beetlebugorg/bittlex/bittle_pi_addon/doc/02_addon.png

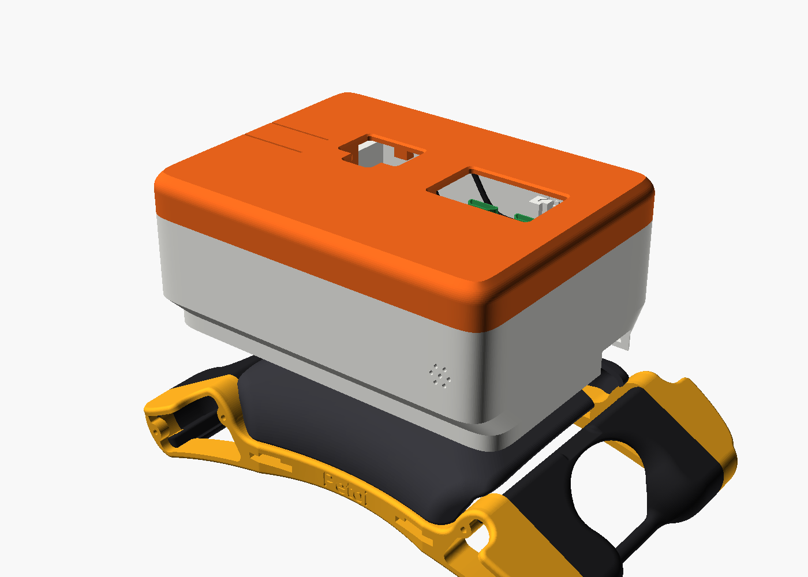
bittle_pi_addon/doc/02_addon.png
