beetlebugorg/bittlex/bittle_pi_addon/doc/03_rear.png

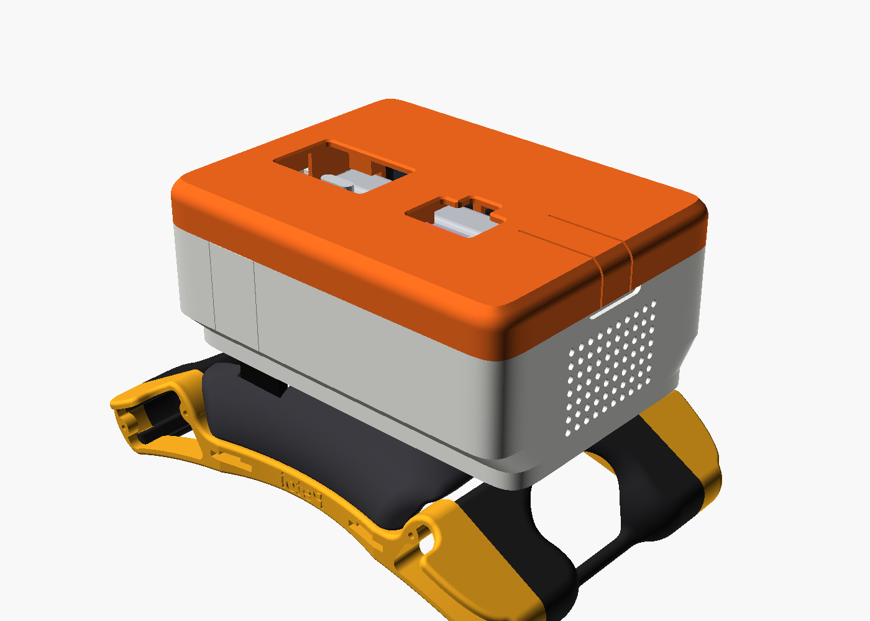
bittle_pi_addon/doc/03_rear.png
