beetlebugorg/bittlex/bittle_pi_addon/doc/04_top.png

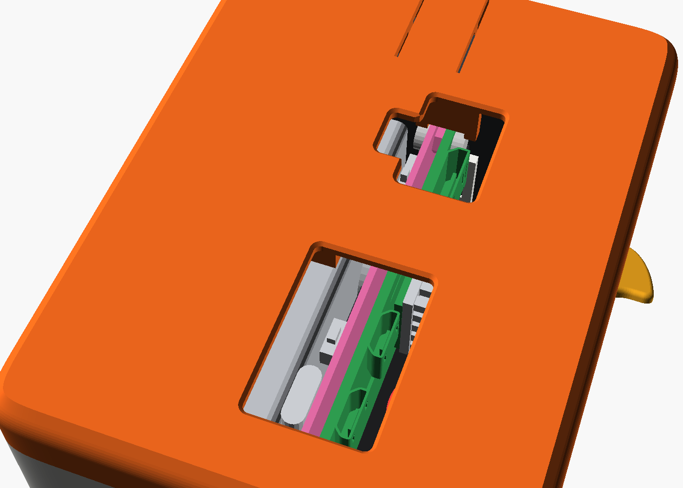
bittle_pi_addon/doc/04_top.png
