beetlebugorg/bittlex/bittle_pi_addon/doc/05_front_notch.png

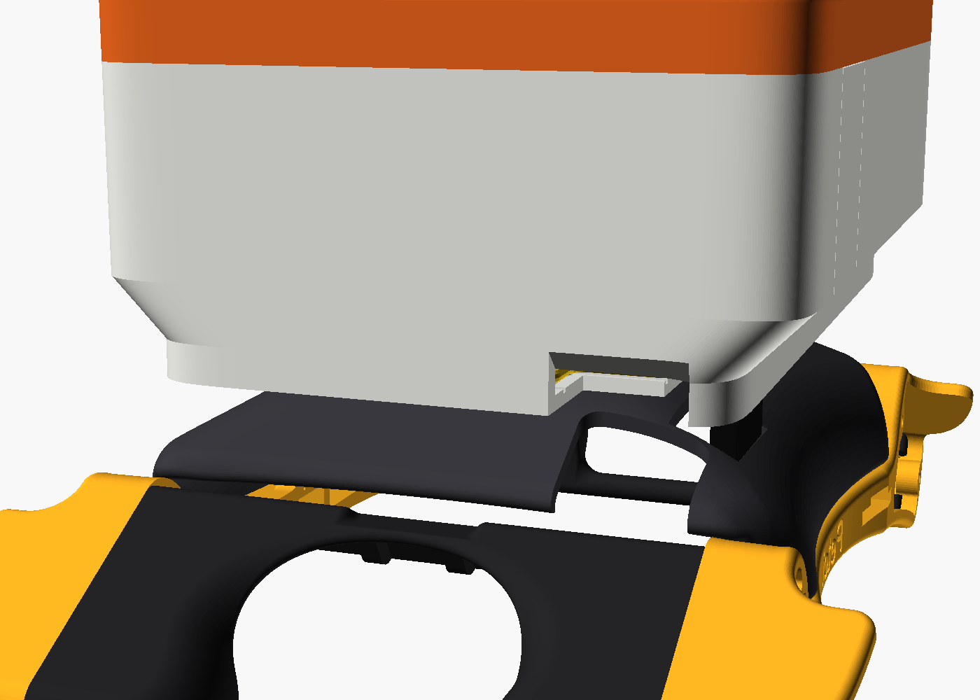
bittle_pi_addon/doc/05_front_notch.png
