beetlebugorg/bittlex/bittle_pi_addon/doc/07_open_left.png

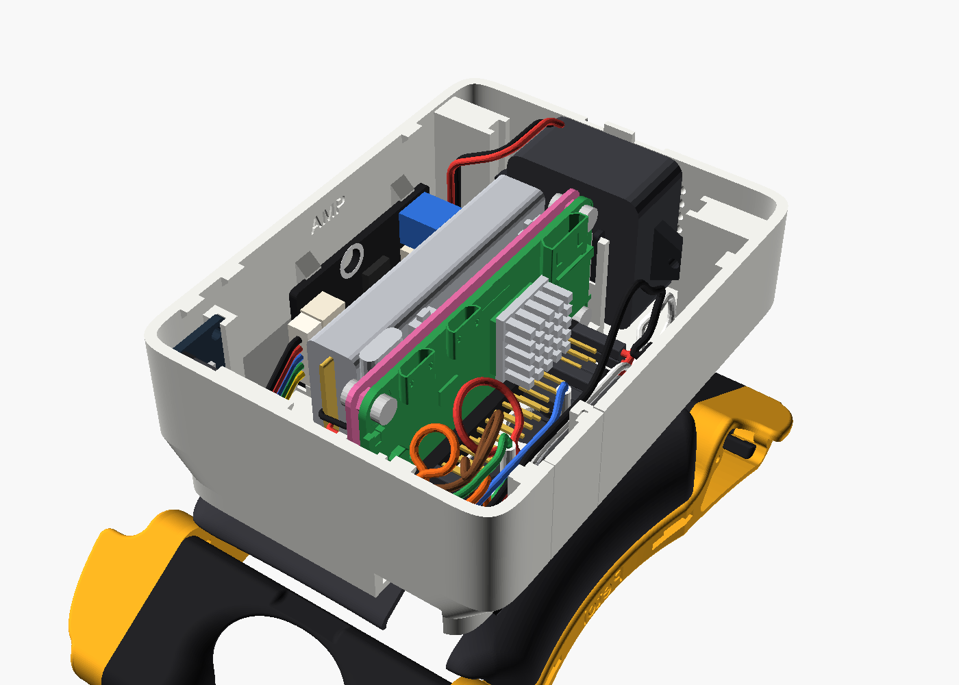
bittle_pi_addon/doc/07_open_left.png
