beetlebugorg/bittlex/bittle_pi_addon/doc/12_wires_left.png

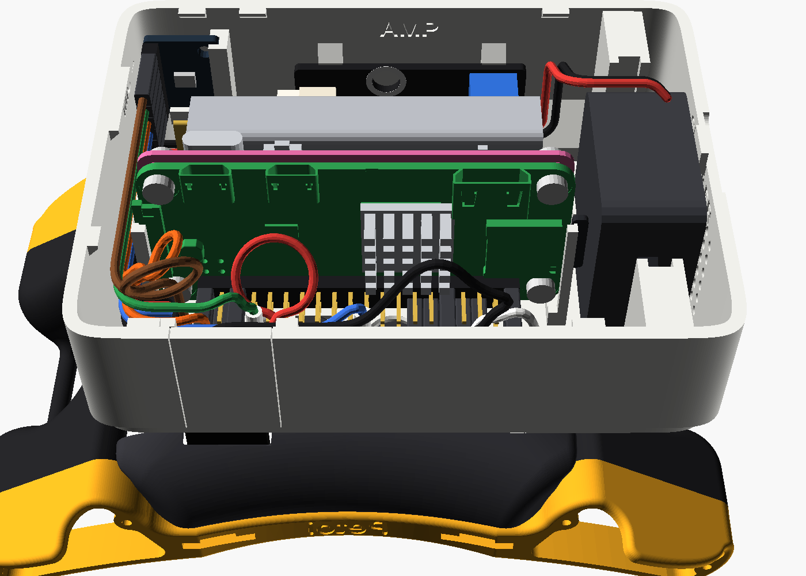
bittle_pi_addon/doc/12_wires_left.png
