beetlebugorg/bittlex/bittle_pi_addon/doc/cover.png

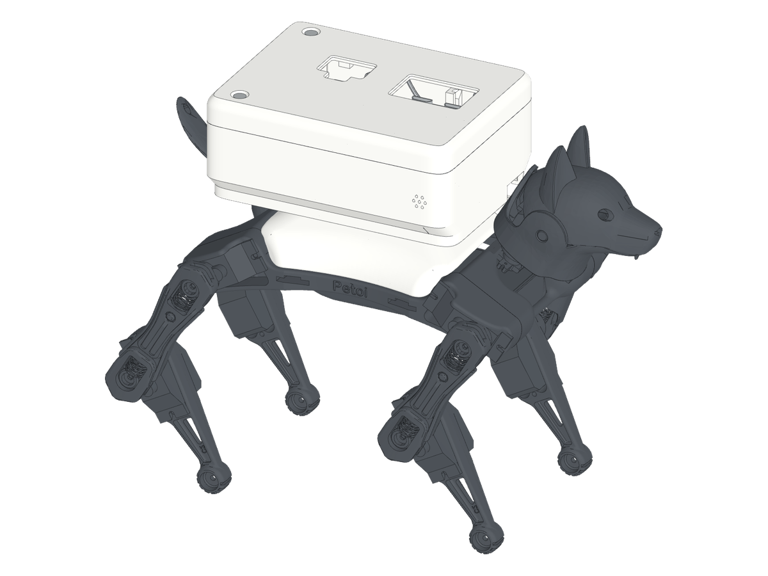
bittle_pi_addon/doc/cover.png
