beetlebugorg/bittlex/bittle_pi_addon/doc/iso/cover-dark.png

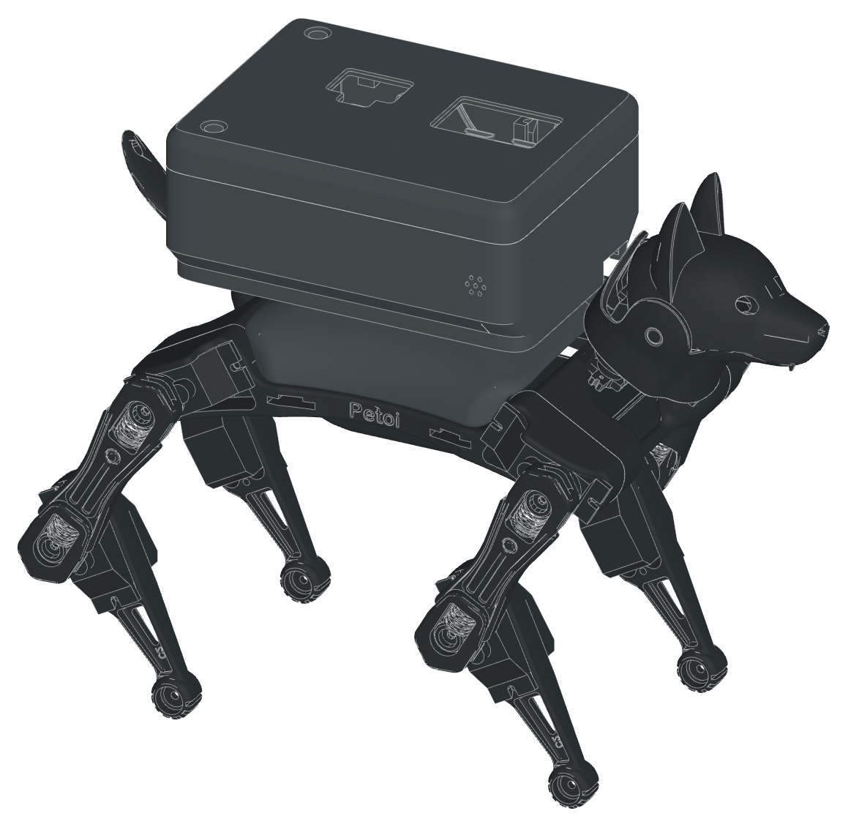
bittle_pi_addon/doc/iso/cover-dark.png
