beetlebugorg/bittlex/bittle_pi_addon/doc/iso/cover-light.png

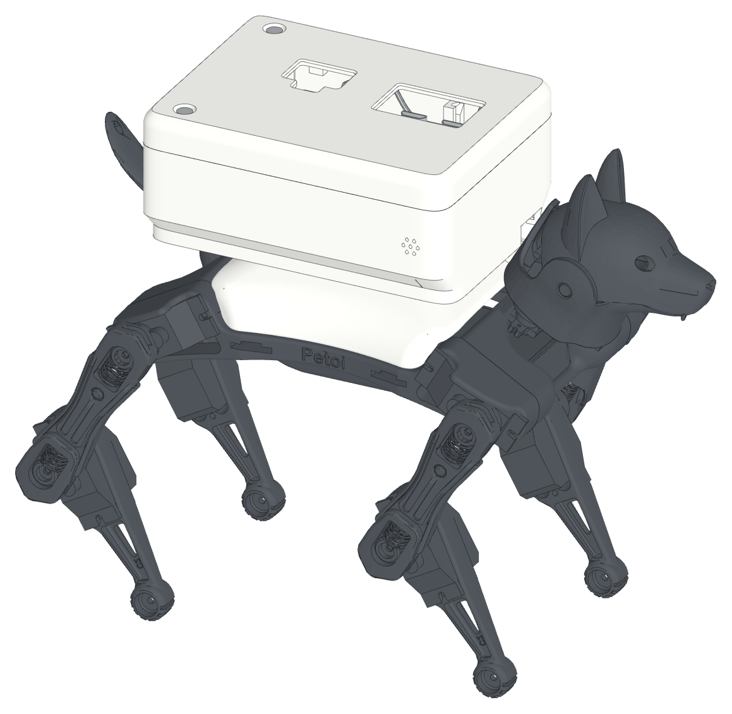
bittle_pi_addon/doc/iso/cover-light.png
