beetlebugorg/bittlex/bittle_pi_addon/doc/iso/exploded-dark.png

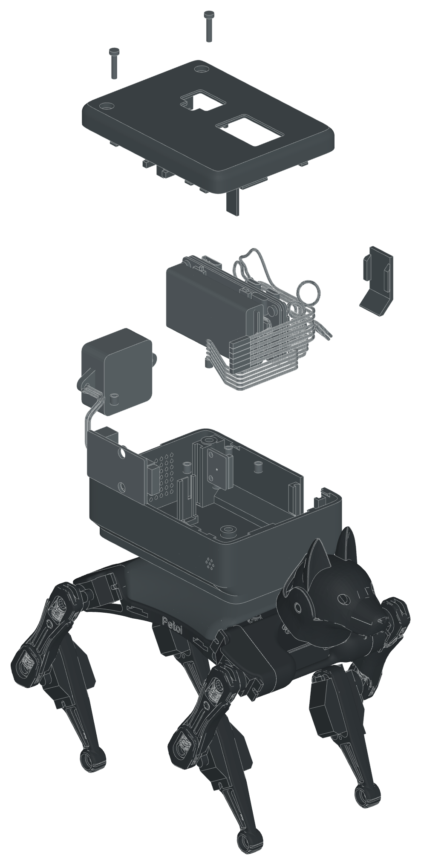
bittle_pi_addon/doc/iso/exploded-dark.png
