beetlebugorg/bittlex/bittle_pi_addon/doc/iso/hero-color-dark.png

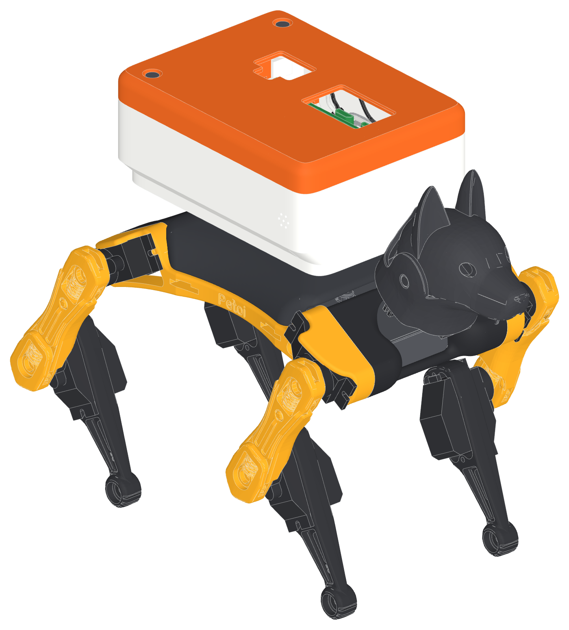
bittle_pi_addon/doc/iso/hero-color-dark.png
