beetlebugorg/bittlex/bittle_pi_addon/doc/iso/hero-dark.png

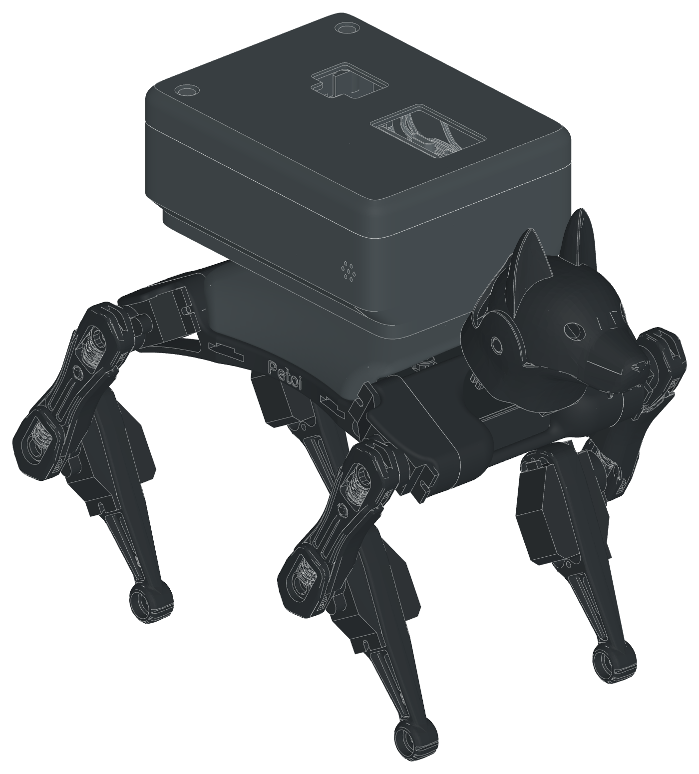
bittle_pi_addon/doc/iso/hero-dark.png
