beetlebugorg/bittlex/bittle_pi_addon/doc/iso/wires-dark.png

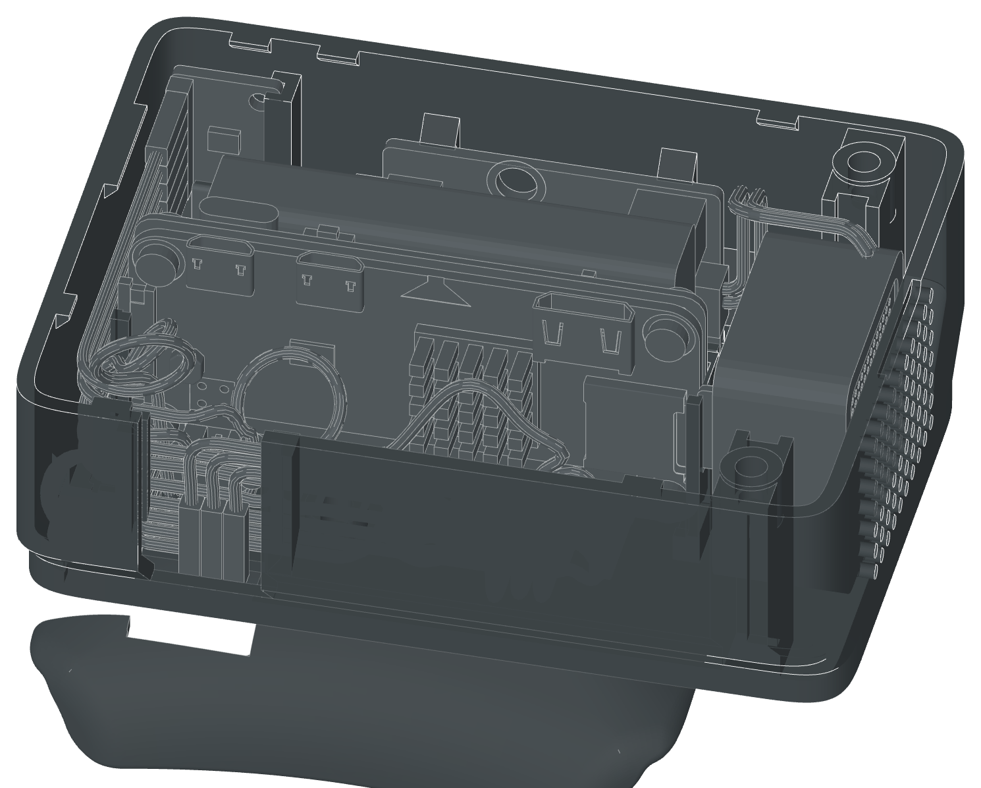
bittle_pi_addon/doc/iso/wires-dark.png
