beetlebugorg/bittlex/bittle_platform/doc/r2_starter.png

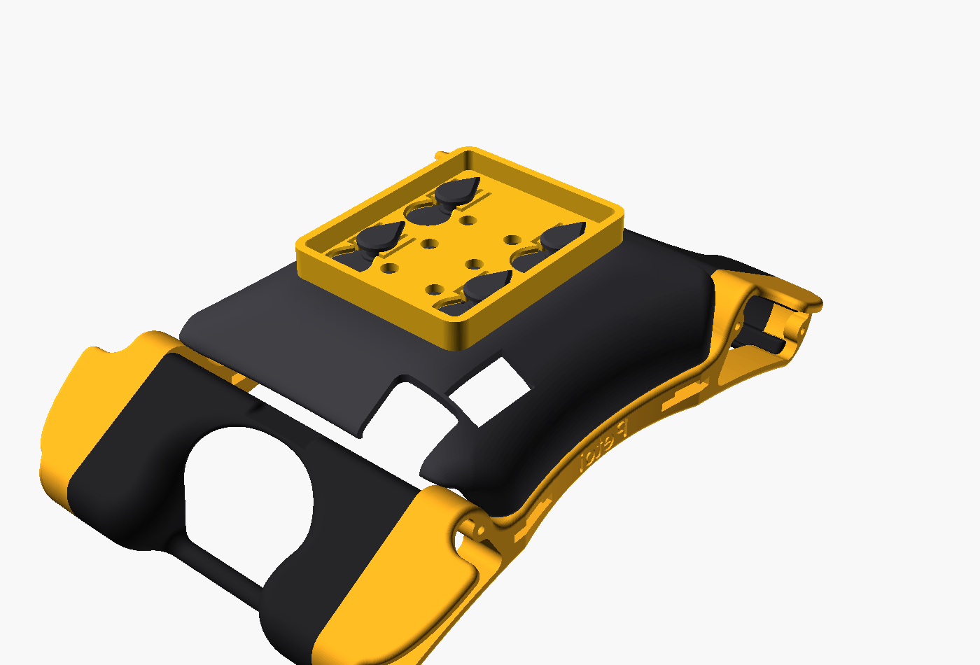
bittle_platform/doc/r2_starter.png
