beetlebugorg/bittlex/bittle_pi_addon/cad/pod_door.step

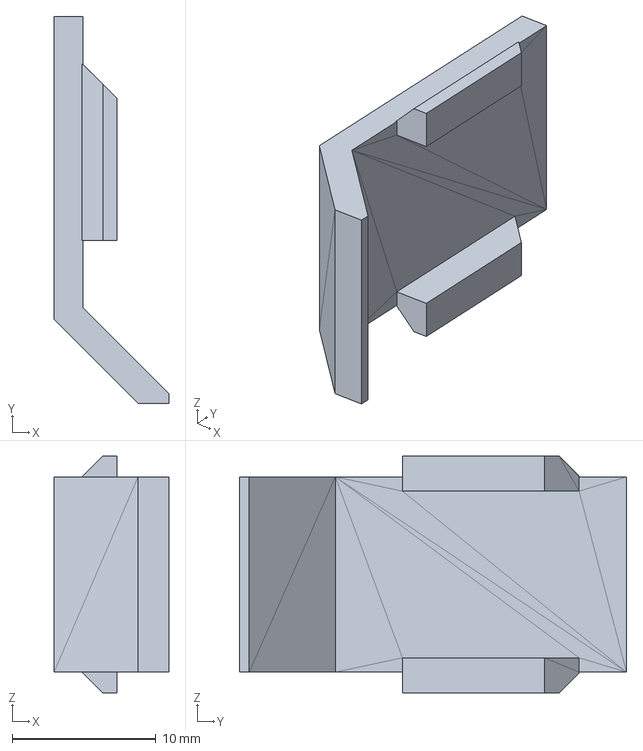
[picture p52: CAD file, 2026-11-01]
bittle_pi_addon/cad/pod_door.step
8.00 x 26.9 x 16.5 mm
