beetlebugorg/bittlex/bittle_pi_addon/stl/assembly/fdm/mount_inserts.stl

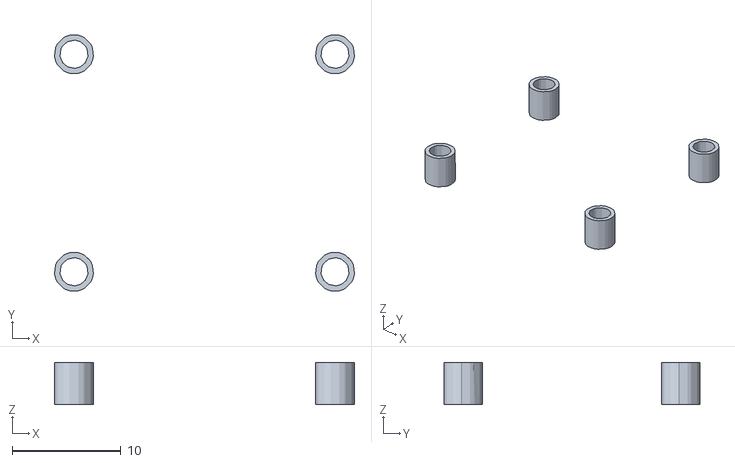
[picture p53: CAD file, 2026-11-03]
bittle_pi_addon/stl/assembly/fdm/mount_inserts.stl
27.6 x 23.5 x 3.90
