beetlebugorg/bittlex/bittle_pi_addon/stl/models/parts/wires_uart__gnd.stl

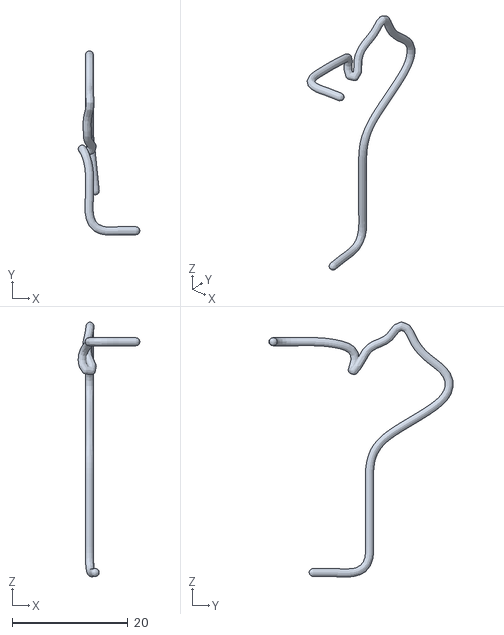
[picture p54: CAD file, 2026-10-31]
bittle_pi_addon/stl/models/parts/wires_uart__gnd.stl
10.7 x 31.8 x 44.0
