beetlebugorg/bittlex/bittle_pi_addon/stl/models/wires_uart.stl

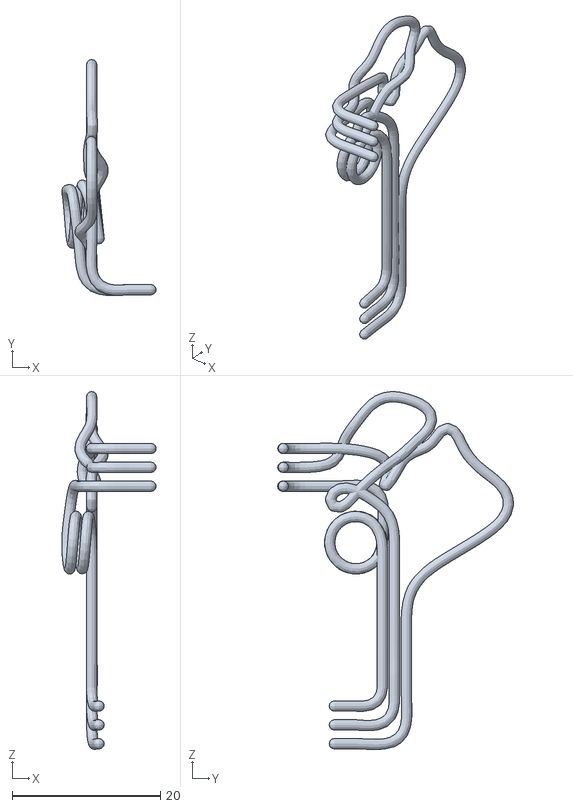
[picture p55: CAD file, 2026-10-31]
bittle_pi_addon/stl/models/wires_uart.stl
12.7 x 31.8 x 48.3
