beetlebugorg/bittlex/bittle_pi_addon/stl/plates/fdm_taz_plate.stl

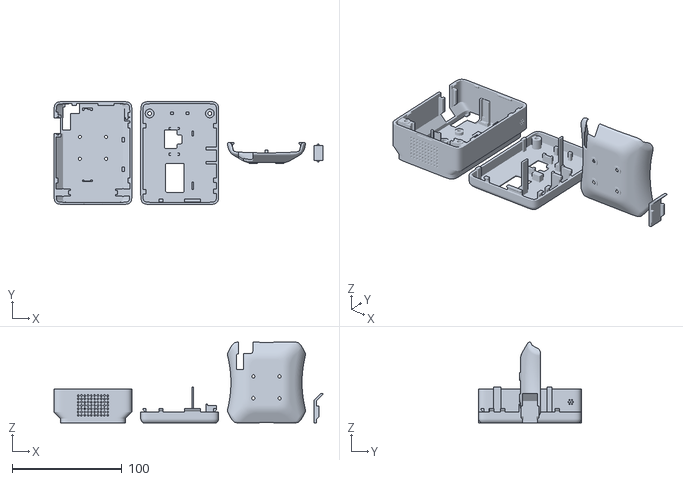
[picture p56: CAD file, 2026-11-01]
bittle_pi_addon/stl/plates/fdm_taz_plate.stl
245.6 x 94.0 x 73.9
