beetlebugorg/bittlex/bittle_pi_addon/stl/print/pod_door_fine.stl

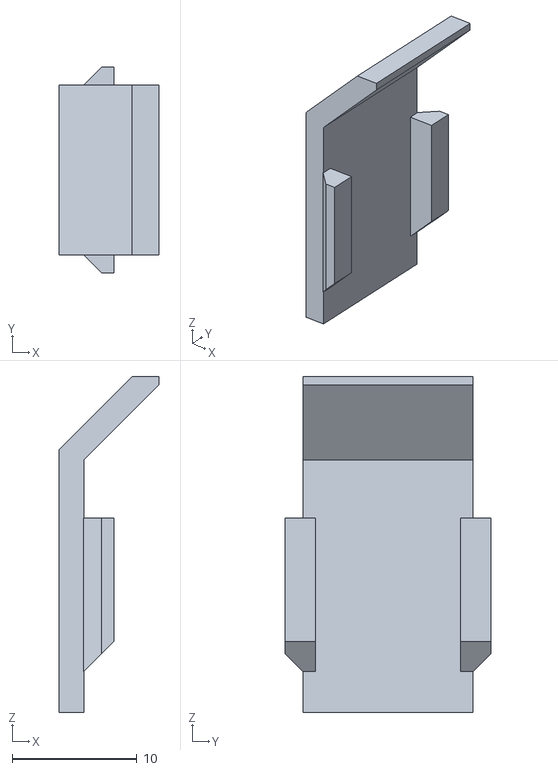
[picture p57: CAD file, 2026-11-01]
bittle_pi_addon/stl/print/pod_door_fine.stl
8.00 x 16.5 x 27.0
