beetlebugorg/bittlex/bittle_platform/cad/detent_bumps.step

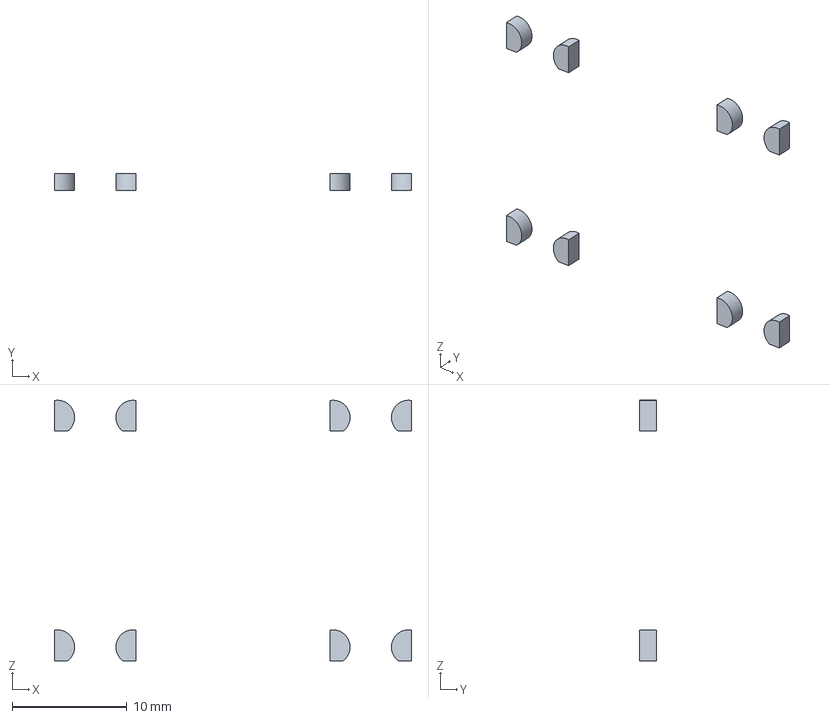
[picture p58: CAD file, 2026-10-31]
bittle_platform/cad/detent_bumps.step
31.1 x 1.50 x 22.7 mm
