beetlebugorg/bittlex/bittle_platform/stl/fit_fine/keyhole_fit_5_gap0.10_click0.35.stl

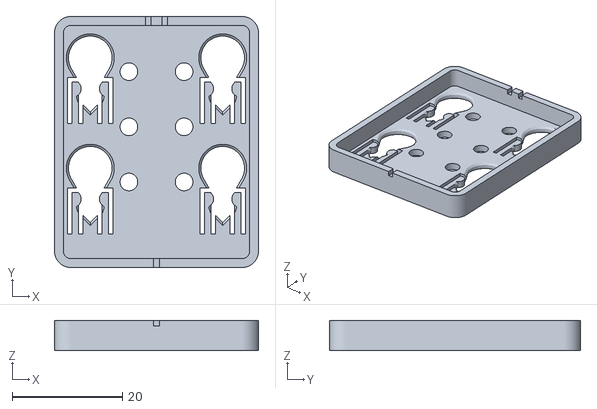
[picture p59: CAD file, 2026-10-31]
bittle_platform/stl/fit_fine/keyhole_fit_5_gap0.10_click0.35.stl
37.0 x 45.5 x 5.50
