beetlebugorg/bittlex/bittle_platform/stl/print/cover_pegs.stl

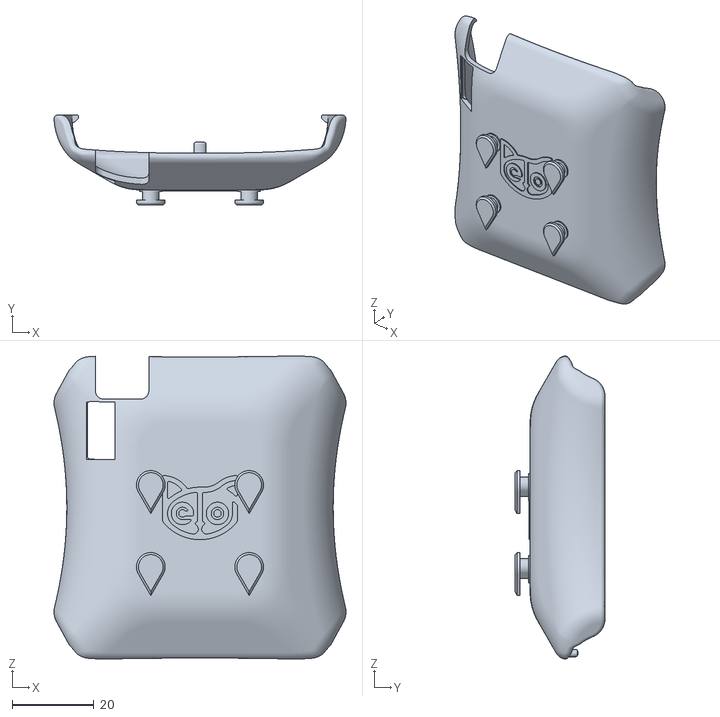
[picture p60: CAD file, 2026-10-31]
bittle_platform/stl/print/cover_pegs.stl
71.2 x 22.0 x 73.9
