beetlebugorg/bittlex/bittle_pi_addon/cad/pod_panel.step

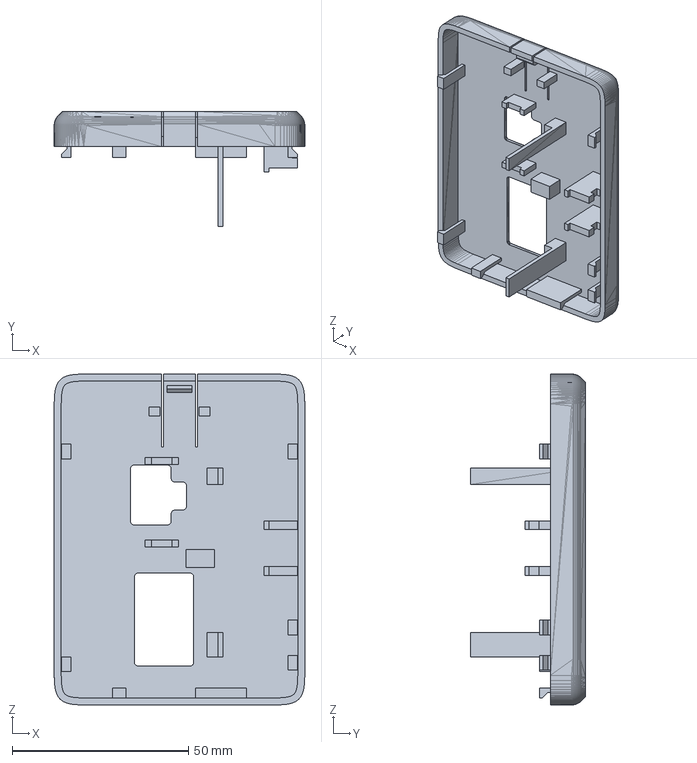
[picture p61: CAD file, 2026-10-31]
bittle_pi_addon/cad/pod_panel.step
71.2 x 32.7 x 94.0 mm
