beetlebugorg/bittlex/bittle_pi_addon/stl/assembly/fdm/panel_inserts.stl

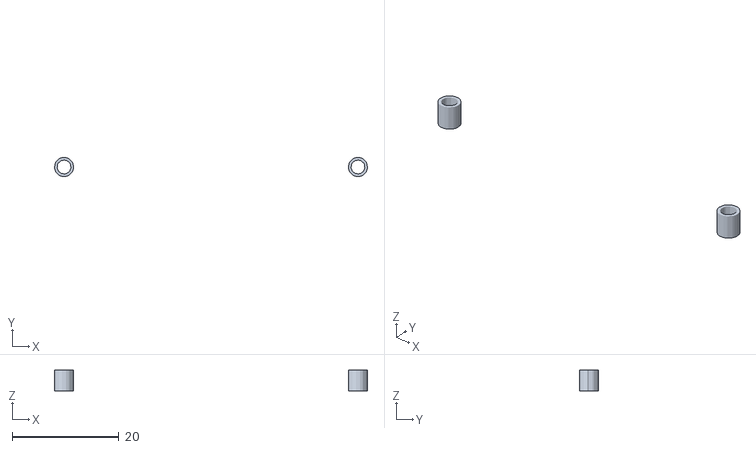
[picture p62: CAD file, 2026-11-03]
bittle_pi_addon/stl/assembly/fdm/panel_inserts.stl
58.6 x 3.51 x 3.90
