beetlebugorg/bittlex/bittle_pi_addon/stl/assembly/resin/pod_panel.stl

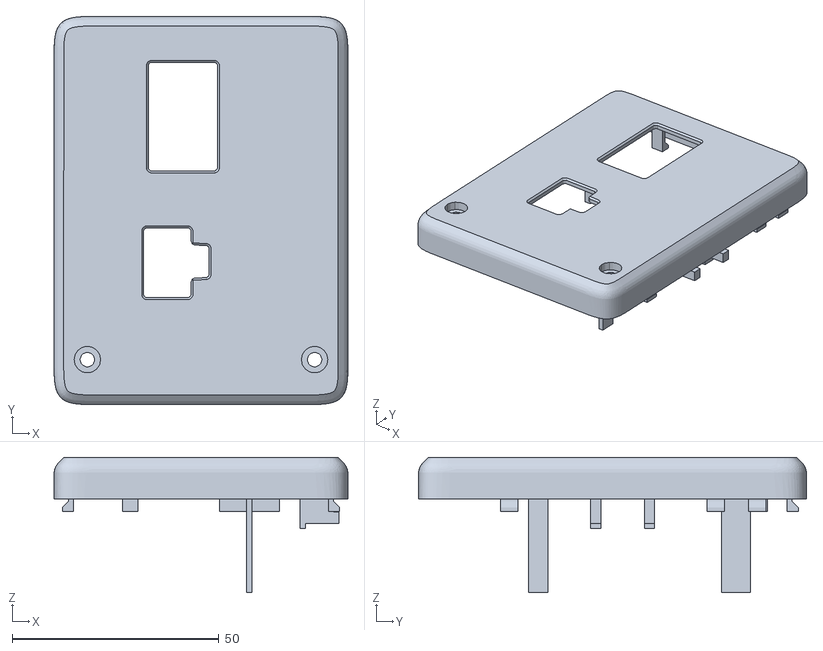
[picture p63: CAD file, 2026-11-02]
bittle_pi_addon/stl/assembly/resin/pod_panel.stl
71.1 x 93.9 x 32.7
