beetlebugorg/bittlex/bittle_pi_addon/stl/models/parts/wires_uart__rx2.stl

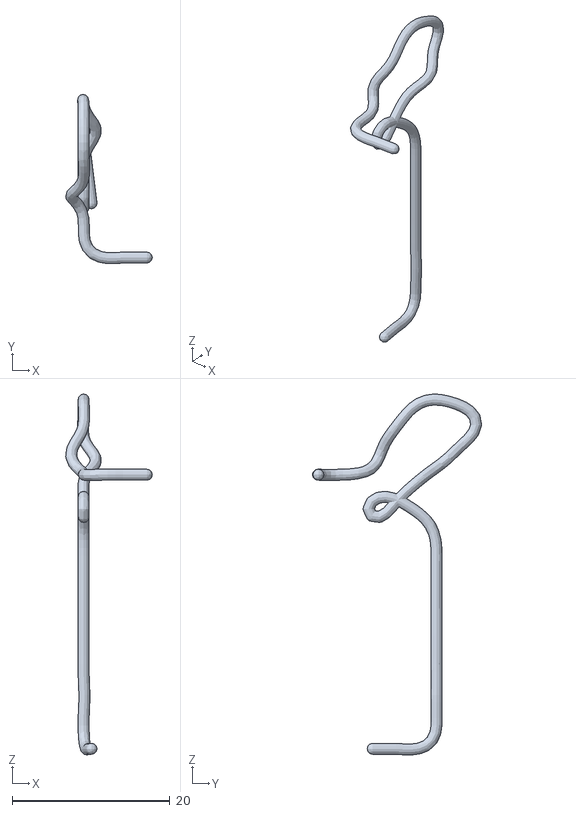
[picture p64: CAD file, 2026-10-31]
bittle_pi_addon/stl/models/parts/wires_uart__rx2.stl
11.0 x 21.4 x 45.7
