beetlebugorg/bittlex/bittle_pi_addon/stl/models/wires_mic.stl

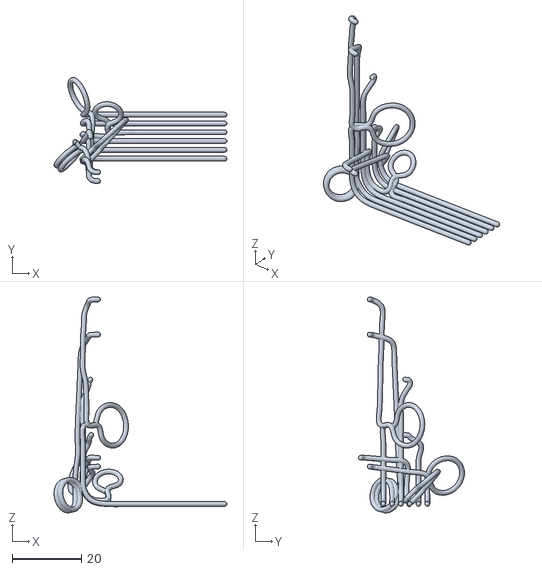
[picture p65: CAD file, 2026-10-31]
bittle_pi_addon/stl/models/wires_mic.stl
49.9 x 30.6 x 62.3
