beetlebugorg/bittlex/bittle_pi_addon/stl/plates/resin_phenom.3mf

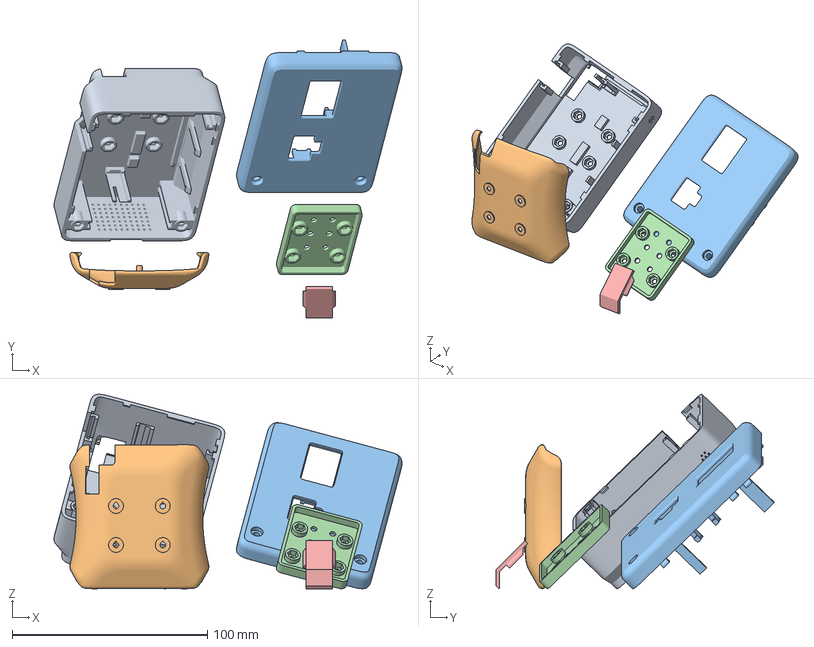
[picture p66: CAD file, 2026-11-01]
bittle_pi_addon/stl/plates/resin_phenom.3mf
178.4 x 142.7 x 99.8 mm
pod_body
cover_screw
pod_panel
starter_plate_screw
pod_door
