beetlebugorg/bittlex/bittle_platform/cad/pegs.step

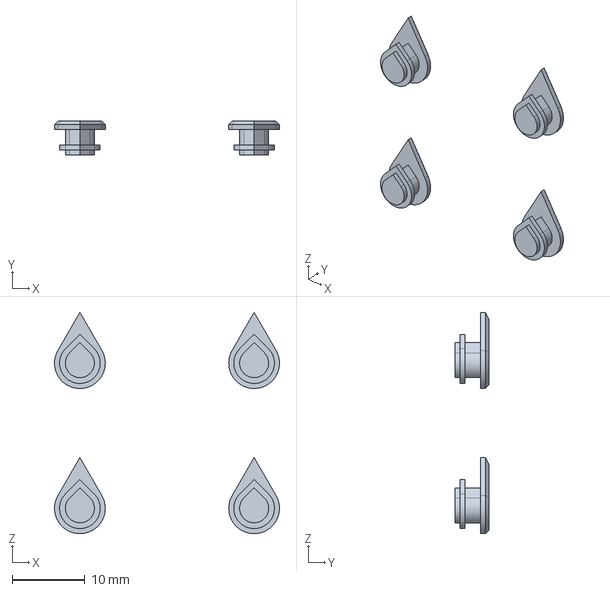
[picture p67: CAD file, 2026-10-31]
bittle_platform/cad/pegs.step
31.0 x 4.70 x 30.5 mm
