beetlebugorg/bittlex/bittle_platform/stl/print/cover_pegs_foot.stl

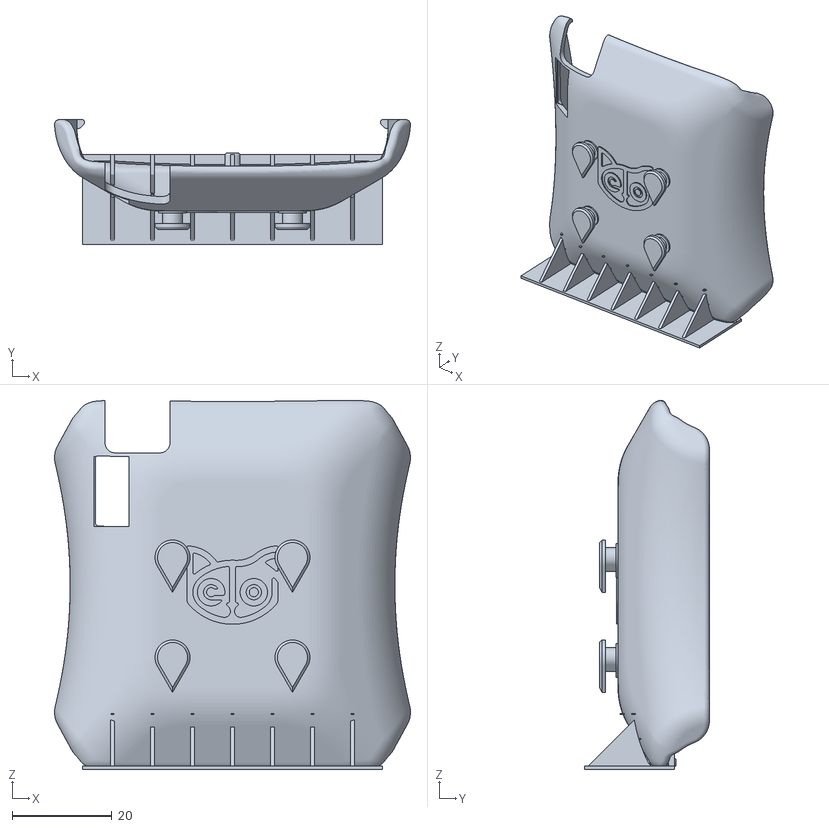
[picture p68: CAD file, 2026-10-31]
bittle_platform/stl/print/cover_pegs_foot.stl
71.2 x 25.0 x 73.9
