beetlebugorg/bittlex/bittle_pi_addon/cad/pod_body.step

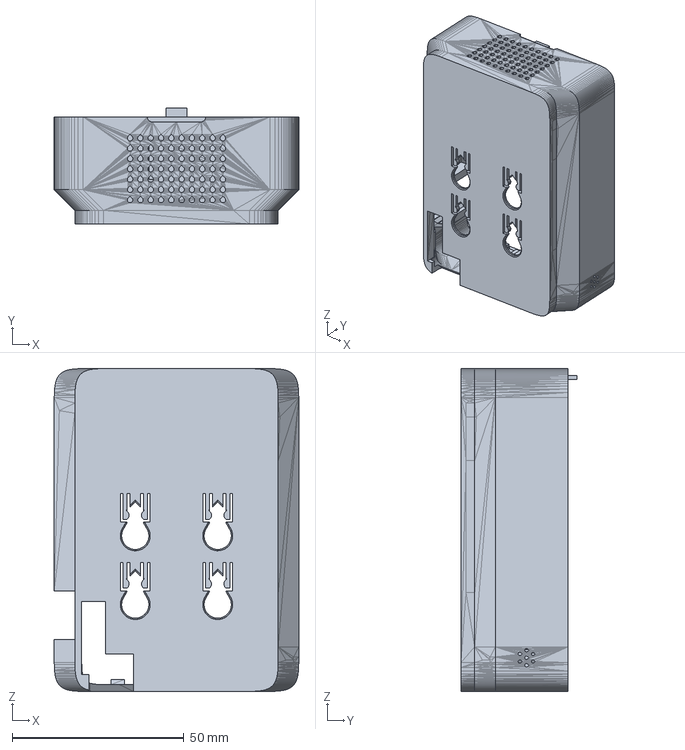
[picture p69: CAD file, 2026-10-31]
bittle_pi_addon/cad/pod_body.step
71.2 x 33.8 x 94.0 mm
