beetlebugorg/bittlex/bittle_pi_addon/stl/assembly/fdm/wires_amp_2e9b4f.stl

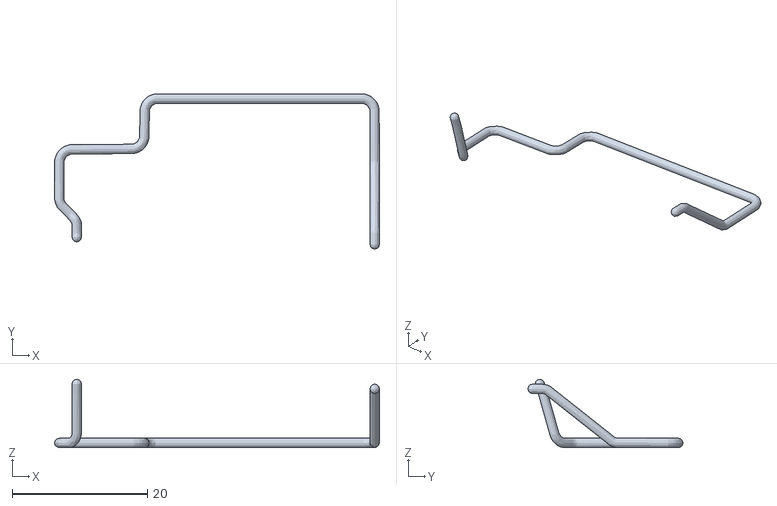
[picture p70: CAD file, 2026-11-03]
bittle_pi_addon/stl/assembly/fdm/wires_amp_2e9b4f.stl
48.0 x 22.9 x 10.1
