beetlebugorg/bittlex/bittle_pi_addon/stl/models/parts/wires_uart__tx2.stl

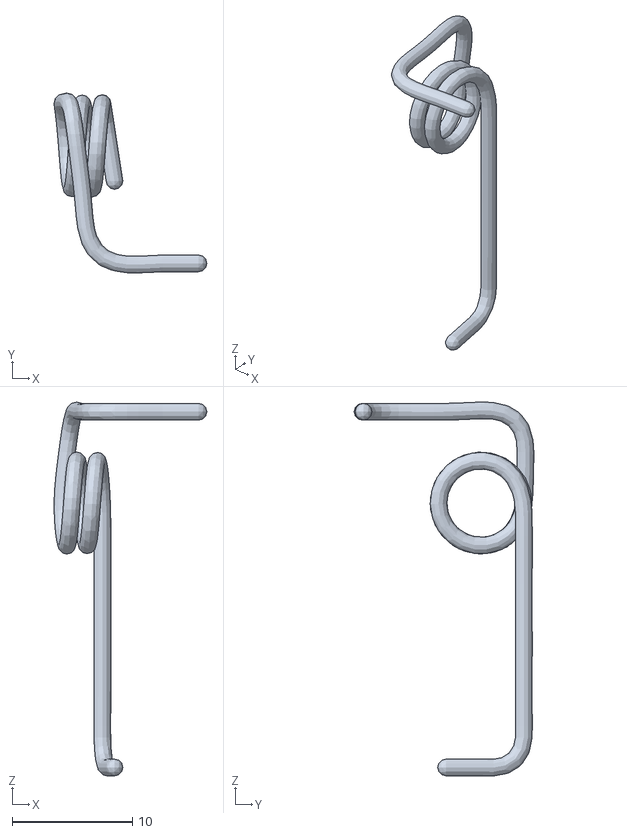
[picture p71: CAD file, 2026-10-31]
bittle_pi_addon/stl/models/parts/wires_uart__tx2.stl
12.7 x 15.0 x 31.2
