beetlebugorg/bittlex/bittle_platform/stl/fit_fine/keyhole_fit_plate5_fdm.stl

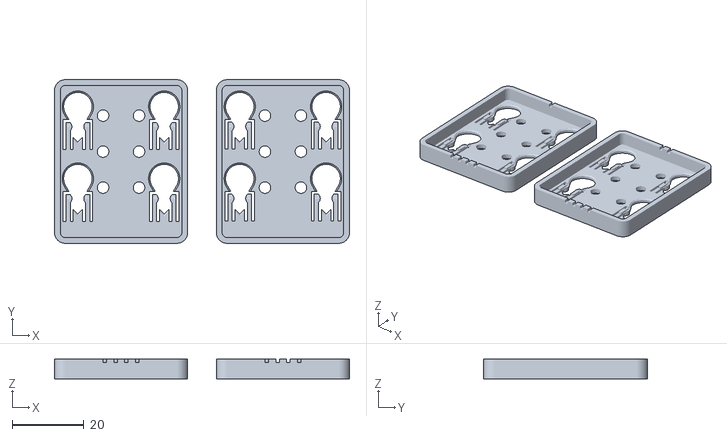
[picture p72: CAD file, 2026-10-31]
bittle_platform/stl/fit_fine/keyhole_fit_plate5_fdm.stl
82.0 x 45.5 x 5.50
