beetlebugorg/bittlex/bittle_pi_addon/stl/assembly/fdm/pisugar_s_c9ccd1.stl

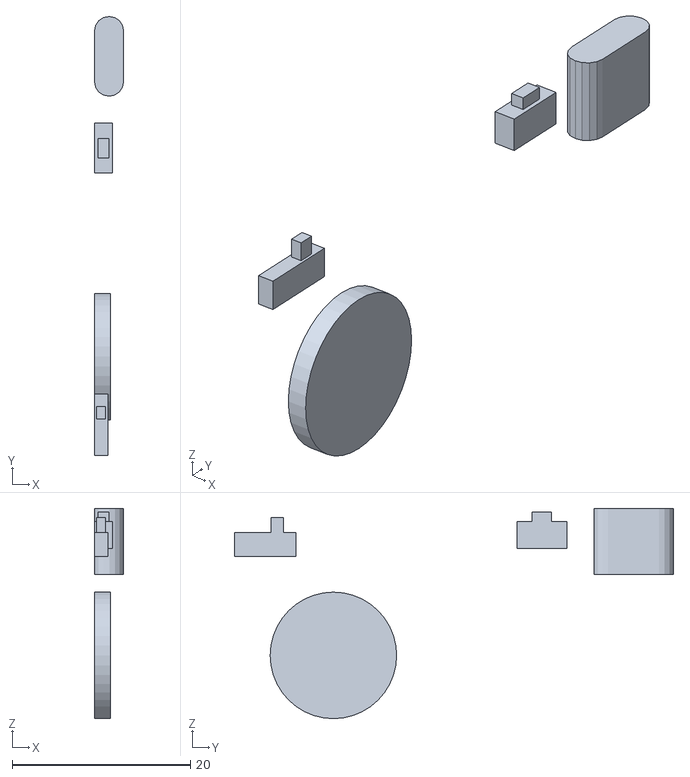
[picture p73: CAD file, 2026-11-03]
bittle_pi_addon/stl/assembly/fdm/pisugar_s_c9ccd1.stl
3.27 x 49.3 x 23.6
