beetlebugorg/bittlex/bittle_pi_addon/stl/assembly/resin/pod_door.stl

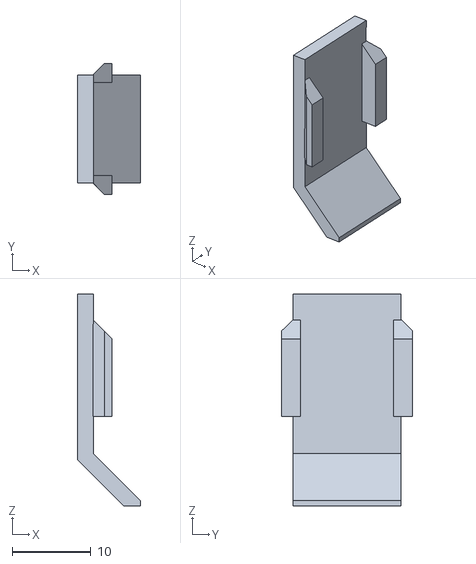
[picture p74: CAD file, 2026-11-02]
bittle_pi_addon/stl/assembly/resin/pod_door.stl
8.00 x 16.7 x 26.9
