beetlebugorg/bittlex/bittle_platform/cad/keyhole_cutter.step

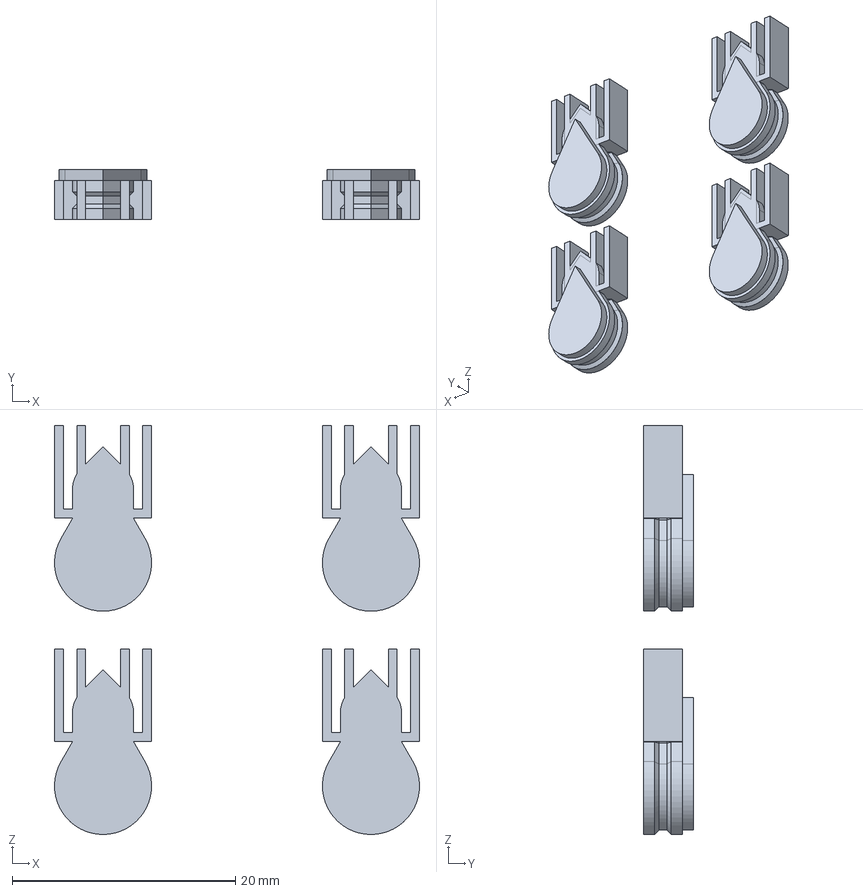
[picture p76: CAD file, 2026-10-31]
bittle_platform/cad/keyhole_cutter.step
32.7 x 4.50 x 36.6 mm
