beetlebugorg/bittlex/bittle_platform/stl/fit_fine/keyhole_fit_plate4_fdm.stl

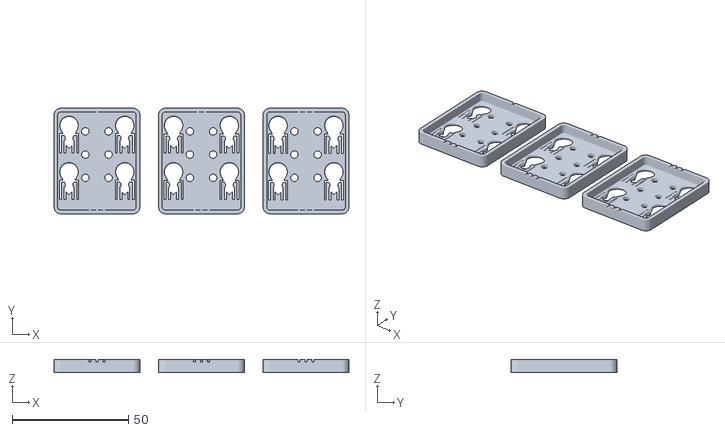
[picture p77: CAD file, 2026-10-31]
bittle_platform/stl/fit_fine/keyhole_fit_plate4_fdm.stl
127.0 x 45.5 x 5.50
