beetlebugorg/bittlex/bittle_pi_addon/stl/assembly/fdm/mic_sph0645_c8c8c8.stl

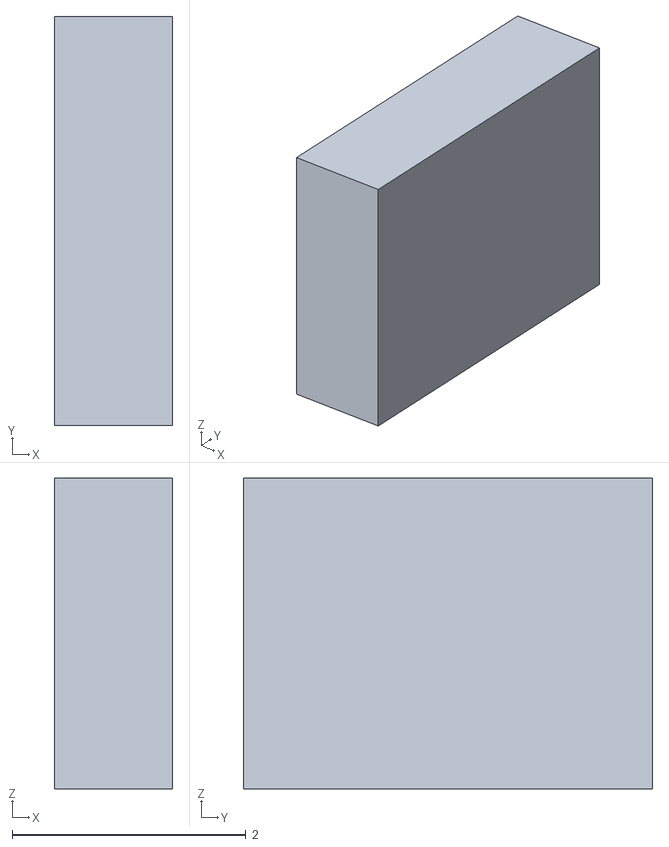
[picture p78: CAD file, 2026-11-03]
bittle_pi_addon/stl/assembly/fdm/mic_sph0645_c8c8c8.stl
1.01 x 3.50 x 2.66
