beetlebugorg/bittlex/bittle_pi_addon/stl/models/parts/wires_mic__sel.stl

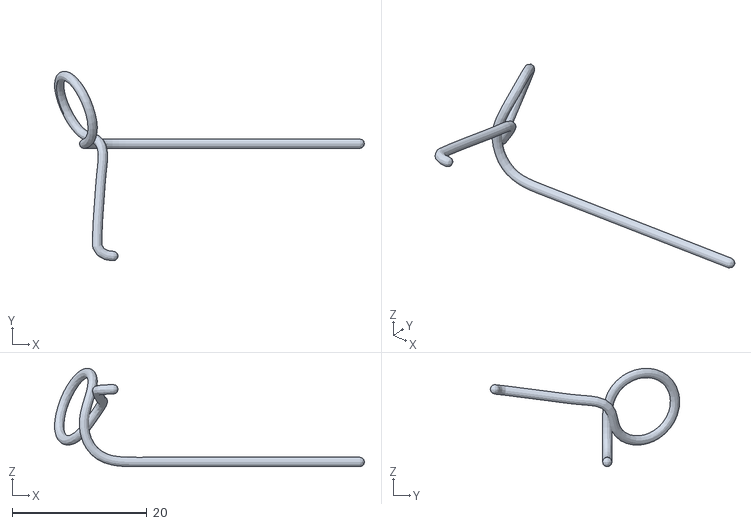
[picture p79: CAD file, 2026-10-31]
bittle_pi_addon/stl/models/parts/wires_mic__sel.stl
45.9 x 28.1 x 14.6
