beetlebugorg/bittlex/bittle_pi_addon/stl/assembly/fdm/amp_ns4168_e8e8e8.stl

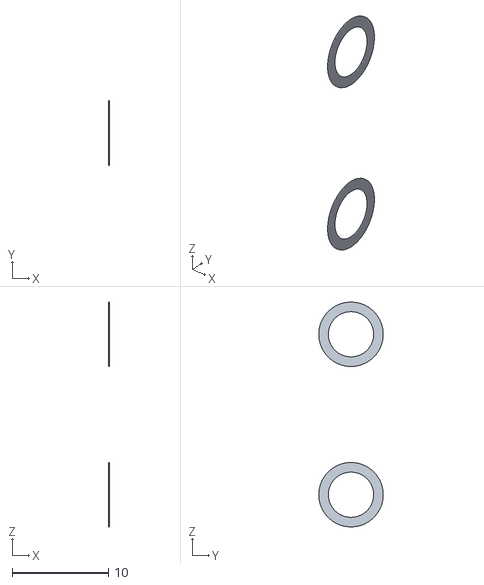
[picture p80: CAD file, 2026-11-03]
bittle_pi_addon/stl/assembly/fdm/amp_ns4168_e8e8e8.stl
0.06 x 6.70 x 23.3
