beetlebugorg/bittlex/bittle_pi_addon/stl/assembly/resin/pod_body.stl

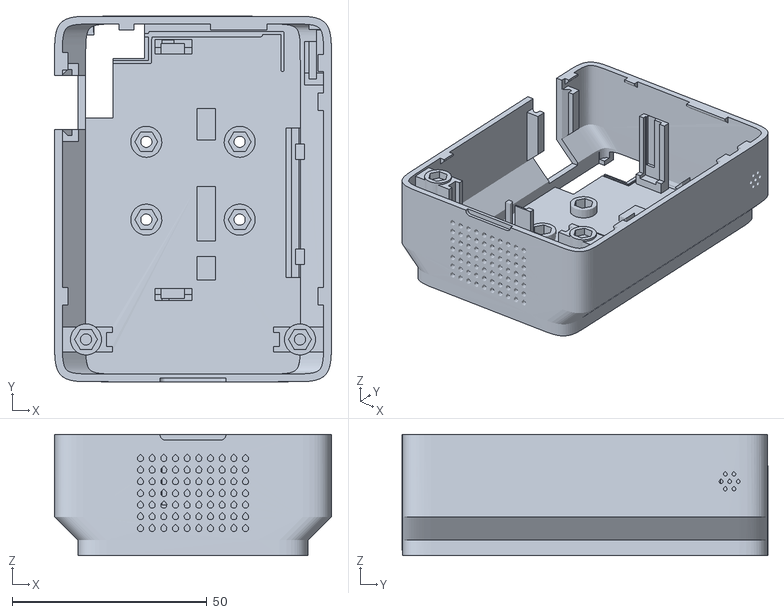
[picture p81: CAD file, 2026-11-02]
bittle_pi_addon/stl/assembly/resin/pod_body.stl
71.2 x 94.0 x 31.2
