beetlebugorg/bittlex/bittle_pi_addon/stl/assembly/fdm/sd_card_26272b.stl

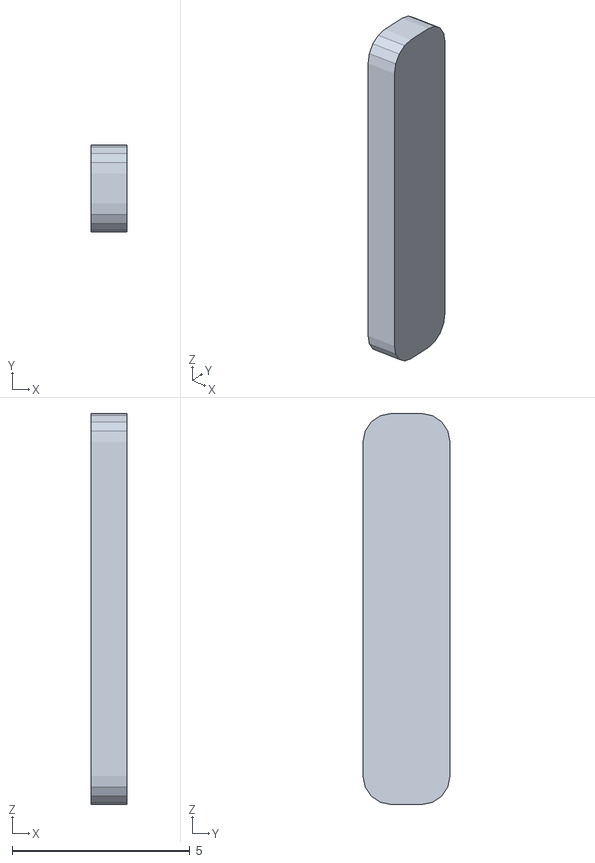
[picture p82: CAD file, 2026-11-03]
bittle_pi_addon/stl/assembly/fdm/sd_card_26272b.stl
1.00 x 2.45 x 11.0
