beetlebugorg/bittlex/bittle_pi_addon/stl/assembly/fdm/dupont_housings.stl

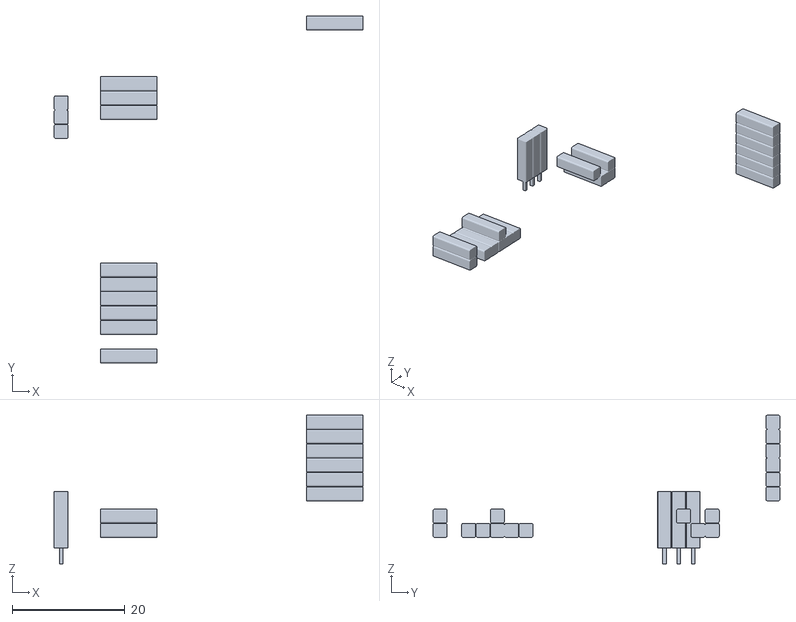
[picture p83: CAD file, 2026-11-03]
bittle_pi_addon/stl/assembly/fdm/dupont_housings.stl
54.8 x 61.5 x 26.4
