beetlebugorg/bittlex/bittle_pi_addon/stl/assembly/fdm/pizero_2e9b4f.stl

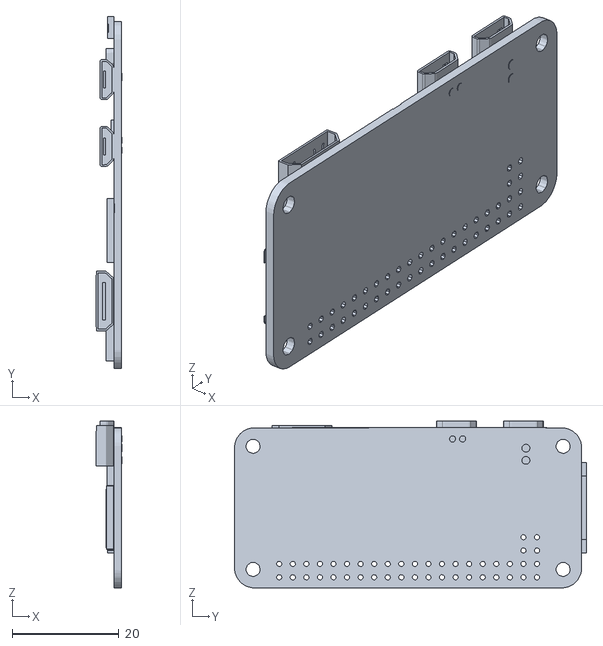
[picture p84: CAD file, 2026-11-03]
bittle_pi_addon/stl/assembly/fdm/pizero_2e9b4f.stl
4.80 x 65.9 x 31.2
