beetlebugorg/bittlex/bittle_pi_addon/stl/assembly/fdm/amp_ns4168_efe6d2.stl

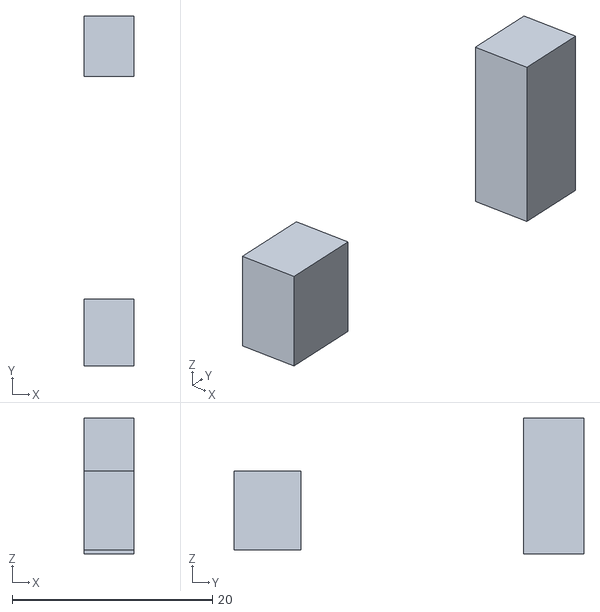
[picture p85: CAD file, 2026-11-03]
bittle_pi_addon/stl/assembly/fdm/amp_ns4168_efe6d2.stl
5.00 x 35.0 x 13.6
