beetlebugorg/bittlex/bittle_pi_addon/stl/assembly/fdm/battery_1d1d1f.stl

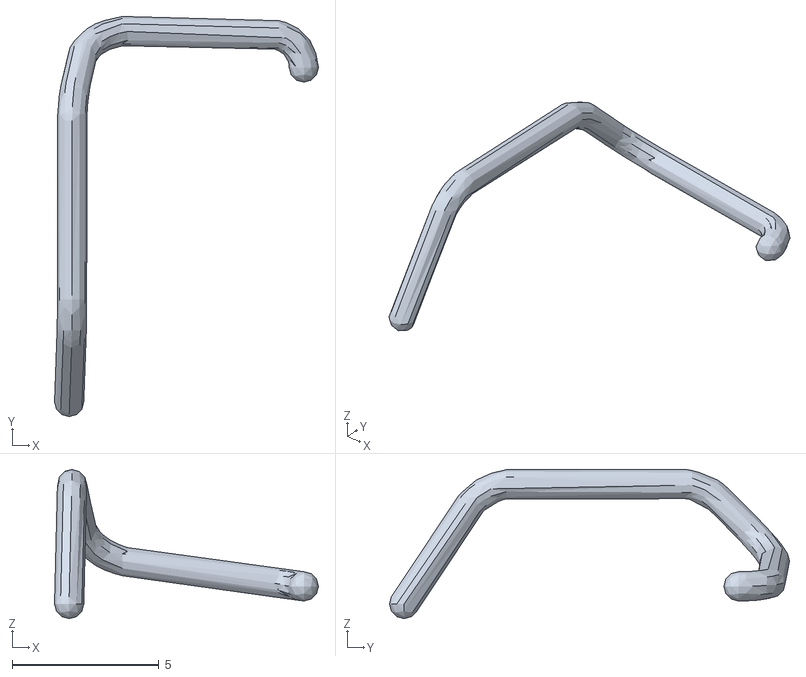
[picture p86: CAD file, 2026-11-03]
bittle_pi_addon/stl/assembly/fdm/battery_1d1d1f.stl
9.00 x 13.6 x 5.09
