beetlebugorg/bittlex/bittle_pi_addon/stl/assembly/fdm/pisugar_s_e06aa3.stl

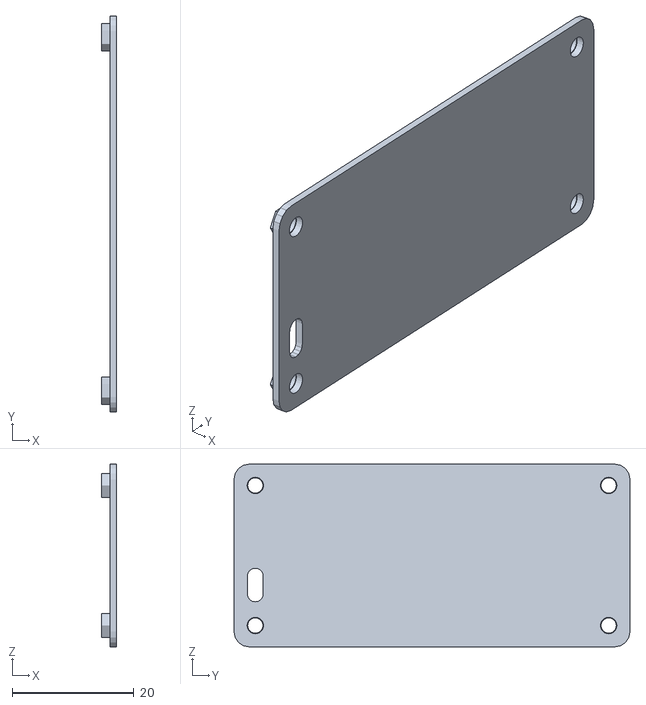
[picture p87: CAD file, 2026-11-03]
bittle_pi_addon/stl/assembly/fdm/pisugar_s_e06aa3.stl
2.40 x 65.0 x 30.0
