beetlebugorg/bittlex/bittle_pi_addon/stl/assembly/fdm/pisugar_s_2b2d33.stl

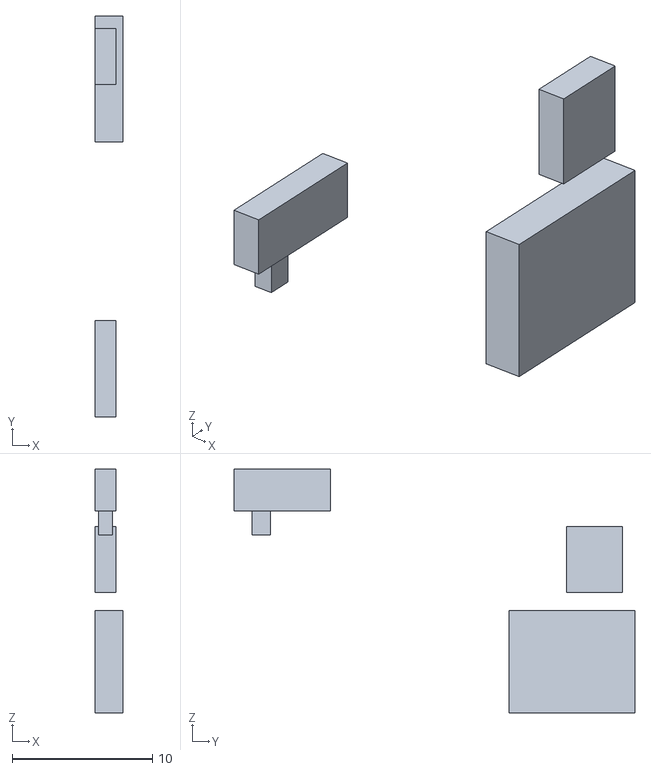
[picture p88: CAD file, 2026-11-03]
bittle_pi_addon/stl/assembly/fdm/pisugar_s_2b2d33.stl
2.00 x 28.6 x 17.4
