beetlebugorg/bittlex/bittle_pi_addon/stl/assembly/fdm/wires_splice_3a6fd8.stl

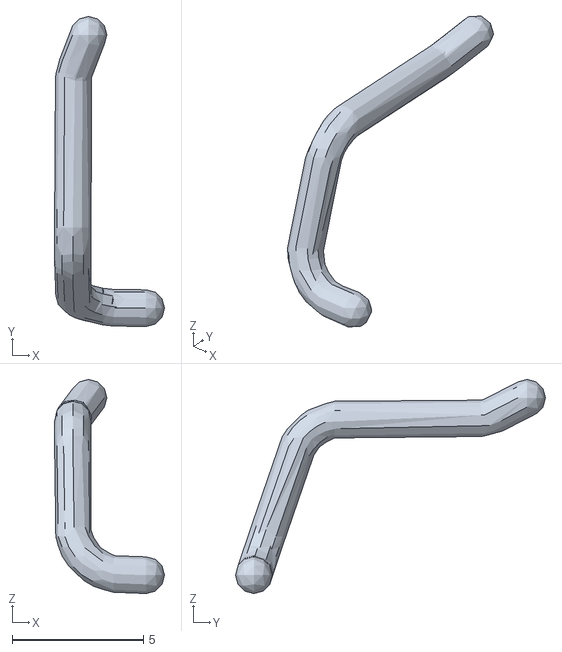
[picture p89: CAD file, 2026-11-03]
bittle_pi_addon/stl/assembly/fdm/wires_splice_3a6fd8.stl
4.20 x 11.8 x 8.17
