beetlebugorg/bittlex/bittle_pi_addon/stl/assembly/fdm/battery_d9b34a.stl

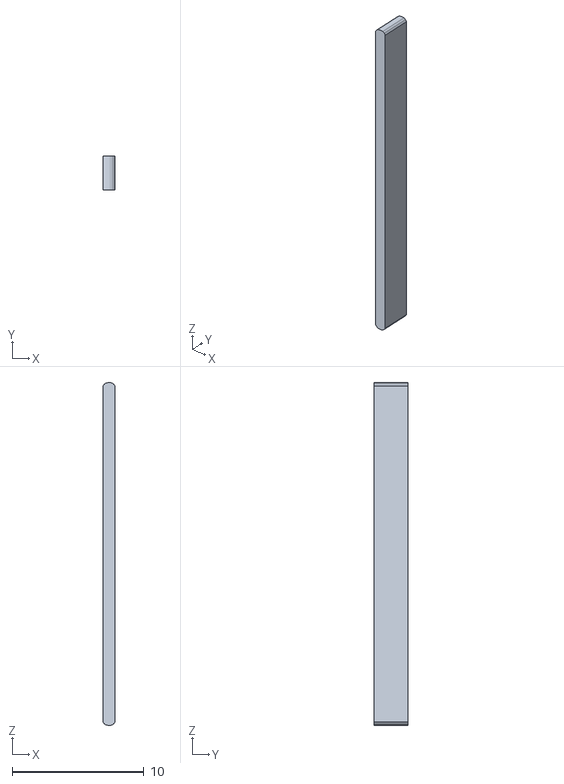
[picture p90: CAD file, 2026-11-03]
bittle_pi_addon/stl/assembly/fdm/battery_d9b34a.stl
0.931 x 2.60 x 26.0
