beetlebugorg/bittlex/bittle_pi_addon/stl/assembly/fdm/speaker_26272b.stl

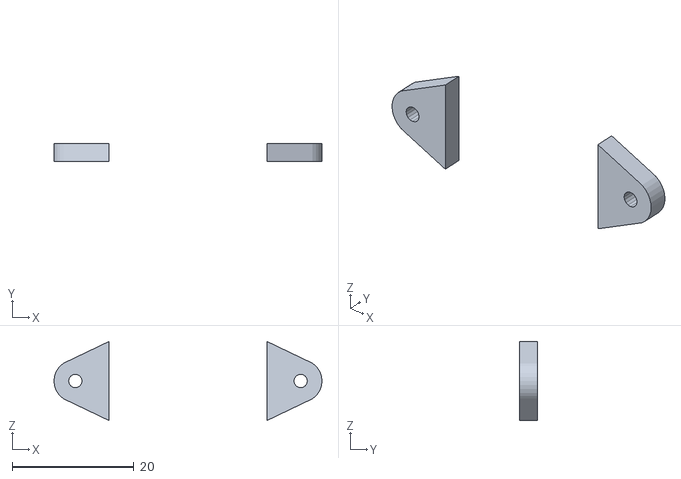
[picture p91: CAD file, 2026-11-03]
bittle_pi_addon/stl/assembly/fdm/speaker_26272b.stl
44.0 x 3.00 x 13.0
