beetlebugorg/bittlex/bittle_pi_addon/stl/assembly/fdm/amp_ns4168_c8c8c8.stl

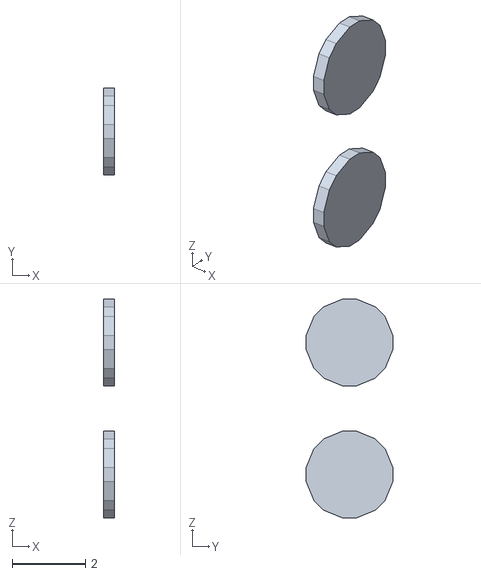
[picture p92: CAD file, 2026-11-03]
bittle_pi_addon/stl/assembly/fdm/amp_ns4168_c8c8c8.stl
0.31 x 2.37 x 5.97
