beetlebugorg/bittlex/bittle_pi_addon/stl/assembly/fdm/amp_ns4168_2f6fd6.stl

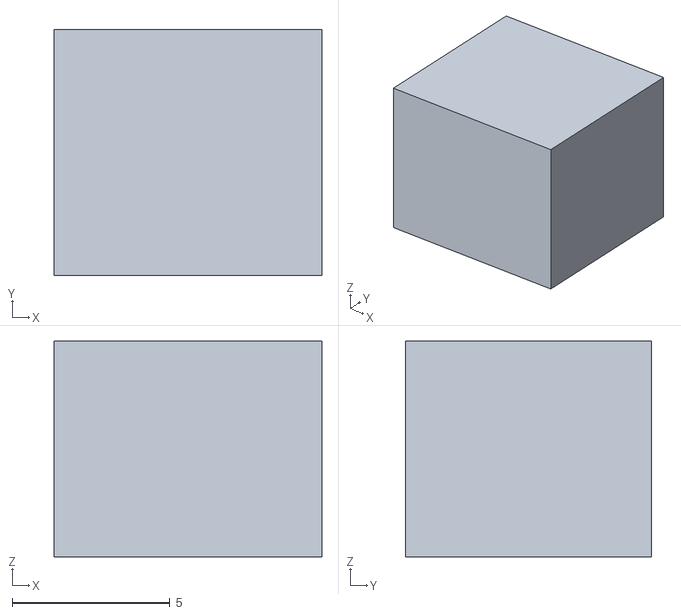
[picture p93: CAD file, 2026-11-03]
bittle_pi_addon/stl/assembly/fdm/amp_ns4168_2f6fd6.stl
8.50 x 7.80 x 6.85
