beetlebugorg/bittlex/bittle_pi_addon/stl/assembly/fdm/pi_plugs_d9b34a.stl

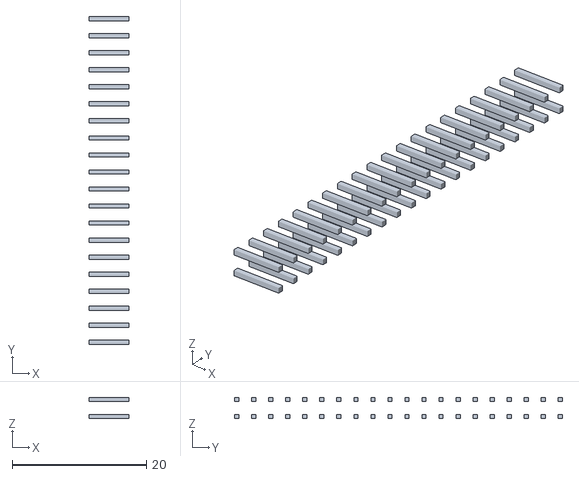
[picture p94: CAD file, 2026-11-03]
bittle_pi_addon/stl/assembly/fdm/pi_plugs_d9b34a.stl
6.01 x 48.9 x 3.18
