beetlebugorg/bittlex/bittle_pi_addon/stl/assembly/fdm/mic_sph0645_22303f.stl

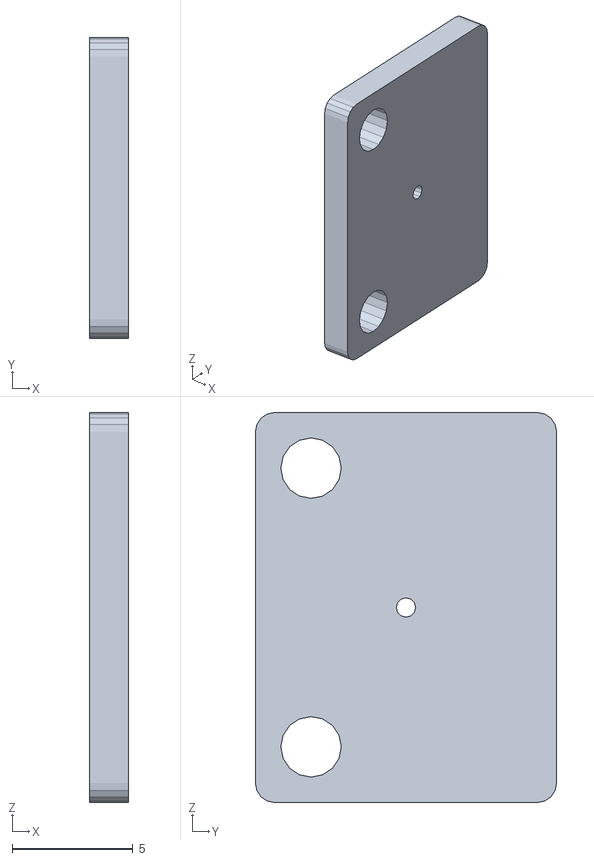
[picture p95: CAD file, 2026-11-03]
bittle_pi_addon/stl/assembly/fdm/mic_sph0645_22303f.stl
1.60 x 12.5 x 16.1
