beetlebugorg/bittlex/bittle_pi_addon/stl/assembly/fdm/amp_ns4168_1d1d1f.stl

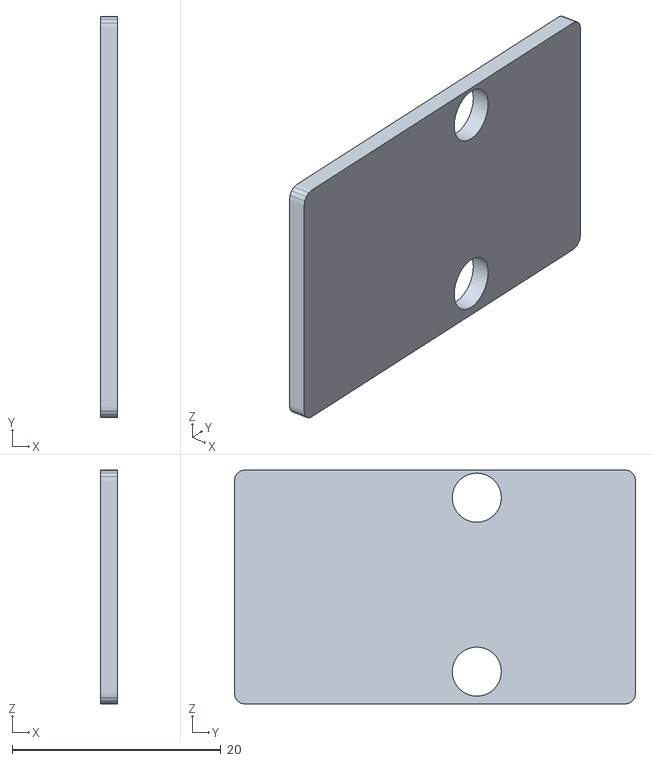
[picture p96: CAD file, 2026-11-03]
bittle_pi_addon/stl/assembly/fdm/amp_ns4168_1d1d1f.stl
1.60 x 38.4 x 22.4
