beetlebugorg/bittlex/bittle_pi_addon/stl/assembly/fdm/pisugar_s_d9b34a.stl

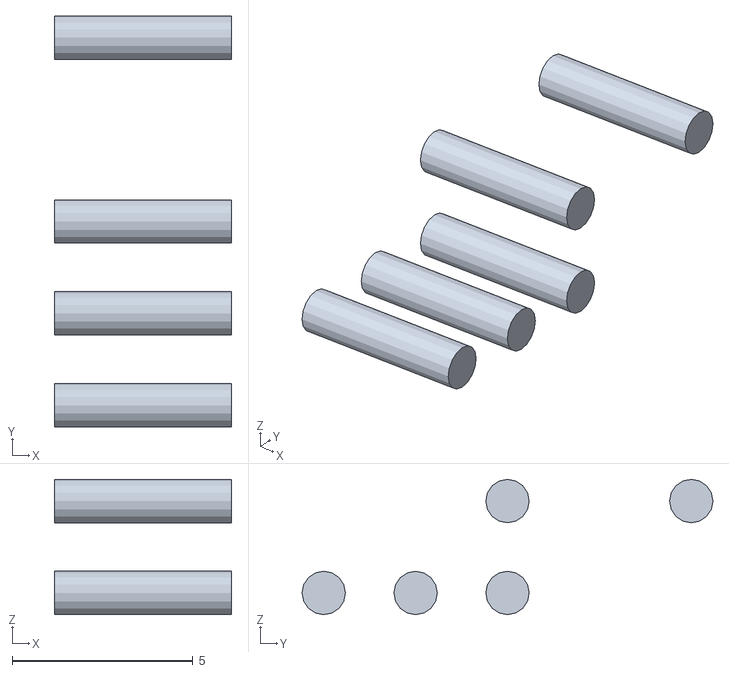
[picture p97: CAD file, 2026-11-03]
bittle_pi_addon/stl/assembly/fdm/pisugar_s_d9b34a.stl
4.90 x 11.4 x 3.74
