beetlebugorg/bittlex/bittle_pi_addon/stl/assembly/fdm/speaker_3a3b40.stl

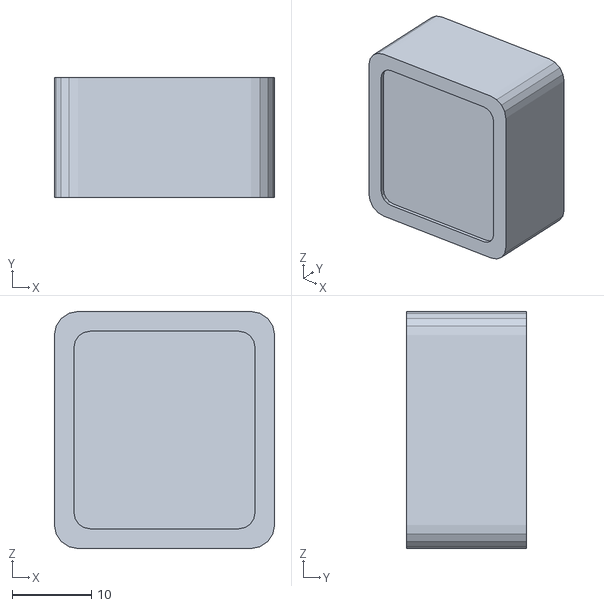
[picture p98: CAD file, 2026-11-03]
bittle_pi_addon/stl/assembly/fdm/speaker_3a3b40.stl
27.9 x 15.2 x 30.0
