beetlebugorg/bittlex/bittle_pi_addon/stl/assembly/fdm/battery_c9ccd1.stl

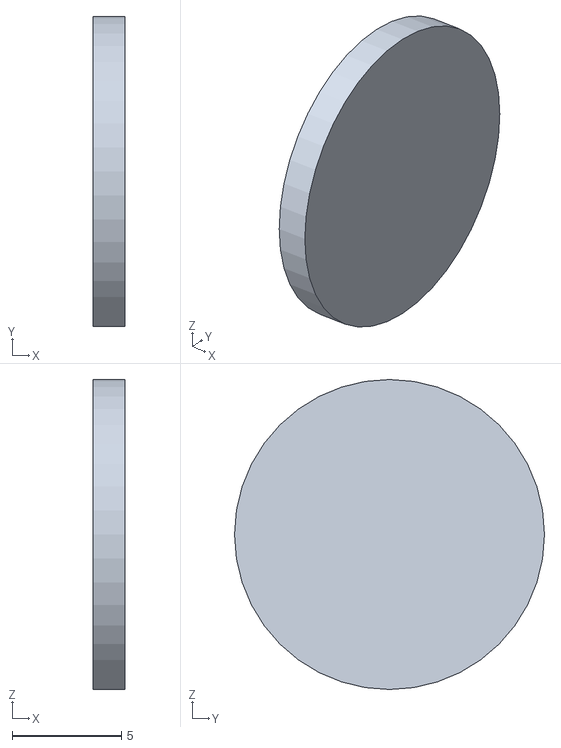
[picture p99: CAD file, 2026-11-03]
bittle_pi_addon/stl/assembly/fdm/battery_c9ccd1.stl
1.46 x 14.2 x 14.2
