beetlebugorg/bittlex/bittle_pi_addon/stl/assembly/fdm/wires_mic_3a6fd8.stl

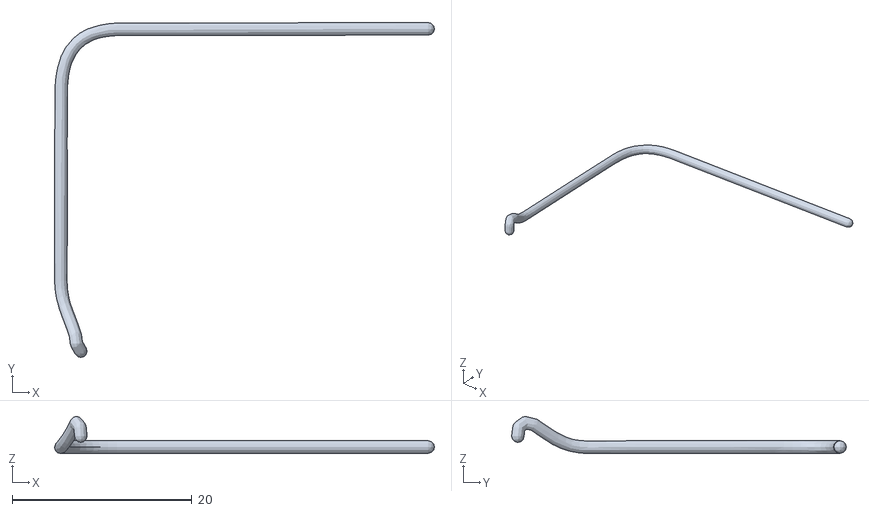
[picture p100: CAD file, 2026-11-03]
bittle_pi_addon/stl/assembly/fdm/wires_mic_3a6fd8.stl
42.3 x 37.3 x 4.14
