beetlebugorg/bittlex/bittle_pi_addon/stl/assembly/fdm/wires_amp_f0c419.stl

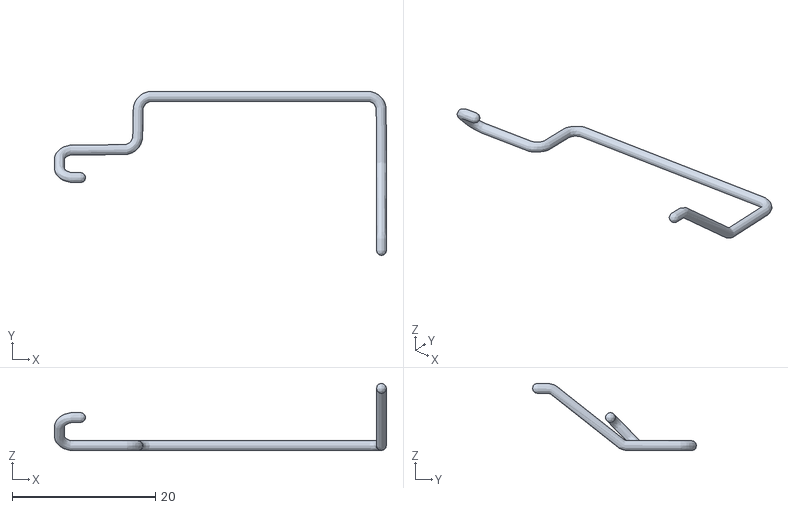
[picture p101: CAD file, 2026-11-03]
bittle_pi_addon/stl/assembly/fdm/wires_amp_f0c419.stl
46.3 x 22.9 x 9.40
