beetlebugorg/bittlex/bittle_pi_addon/stl/assembly/fdm/wires_amp_3a6fd8.stl

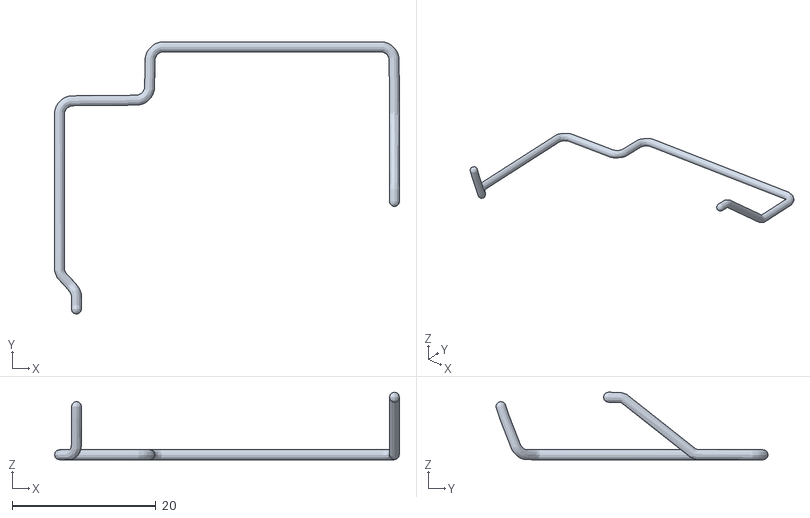
[picture p102: CAD file, 2026-11-03]
bittle_pi_addon/stl/assembly/fdm/wires_amp_3a6fd8.stl
48.0 x 37.8 x 9.40
