beetlebugorg/bittlex/bittle_pi_addon/stl/assembly/fdm/battery_d83a34.stl

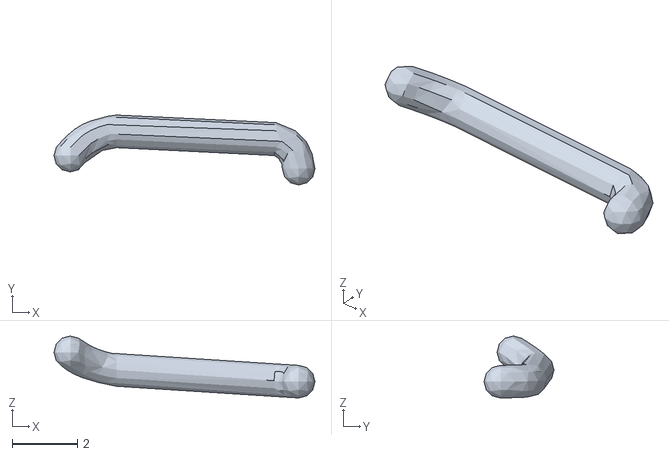
[picture p103: CAD file, 2026-11-03]
bittle_pi_addon/stl/assembly/fdm/battery_d83a34.stl
8.00 x 2.14 x 1.90
