beetlebugorg/bittlex/bittle_pi_addon/stl/assembly/fdm/wires_amp_d83a34.stl

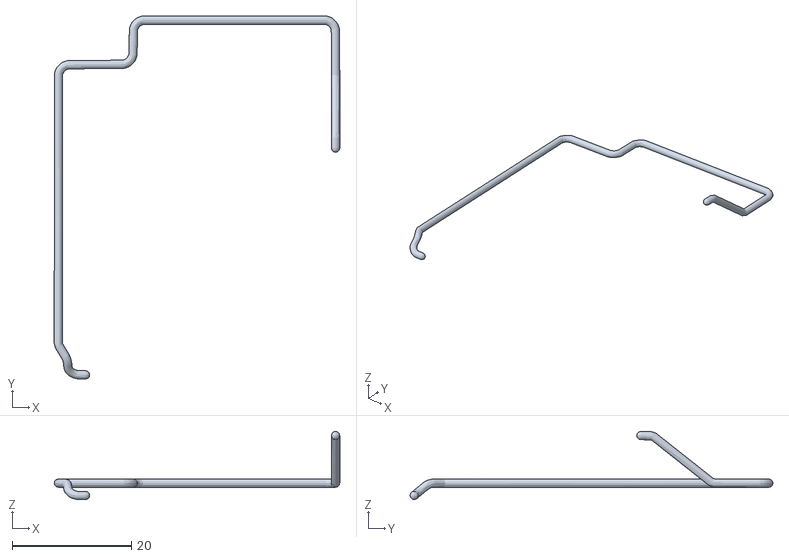
[picture p104: CAD file, 2026-11-03]
bittle_pi_addon/stl/assembly/fdm/wires_amp_d83a34.stl
48.0 x 61.0 x 11.5
