beetlebugorg/bittlex/bittle_pi_addon/stl/assembly/fdm/speaker_5a5b60.stl

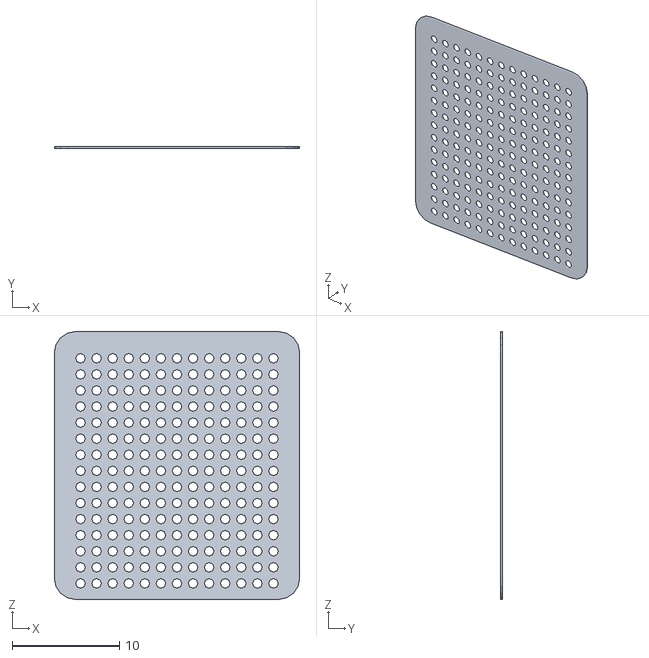
[picture p105: CAD file, 2026-11-03]
bittle_pi_addon/stl/assembly/fdm/speaker_5a5b60.stl
22.9 x 0.2 x 25.0
