beetlebugorg/bittlex/bittle_pi_addon/stl/assembly/fdm/wires_mic_2e9b4f.stl

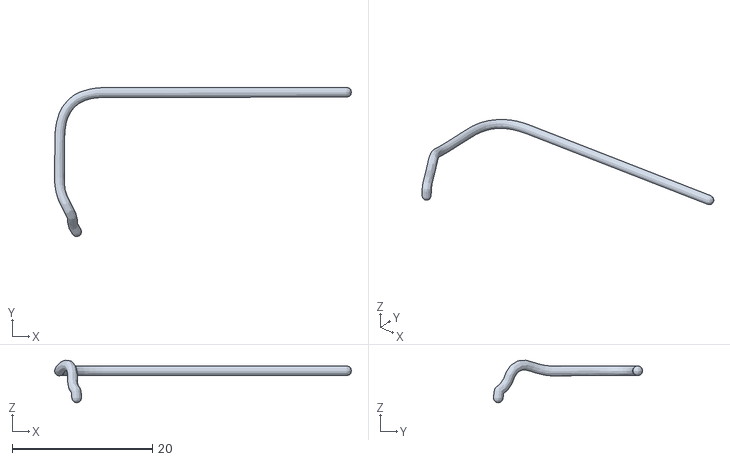
[picture p106: CAD file, 2026-11-03]
bittle_pi_addon/stl/assembly/fdm/wires_mic_2e9b4f.stl
42.4 x 21.3 x 6.07
