beetlebugorg/bittlex/bittle_pi_addon/stl/assembly/fdm/wires_mic_d83a34.stl

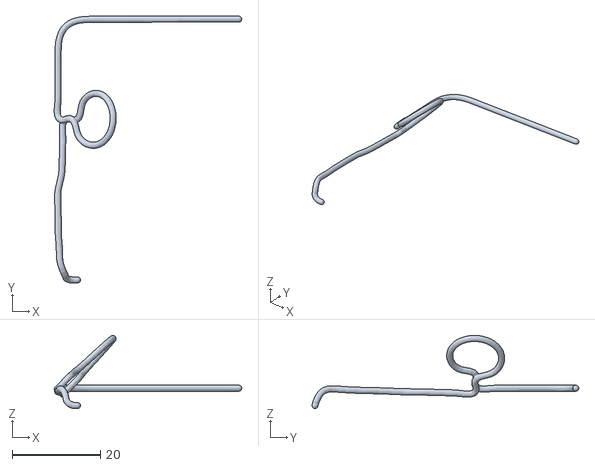
[picture p107: CAD file, 2026-11-03]
bittle_pi_addon/stl/assembly/fdm/wires_mic_d83a34.stl
42.5 x 60.4 x 16.6
