beetlebugorg/bittlex/bittle_pi_addon/stl/assembly/fdm/battery_b9bcc2.stl

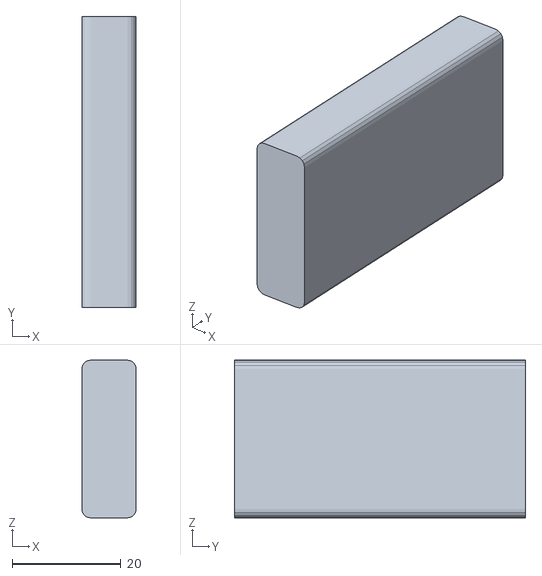
[picture p108: CAD file, 2026-11-03]
bittle_pi_addon/stl/assembly/fdm/battery_b9bcc2.stl
10.00 x 53.5 x 29.0
