beetlebugorg/bittlex/bittle_pi_addon/stl/assembly/fdm/amp_ns4168_fbf6ea.stl

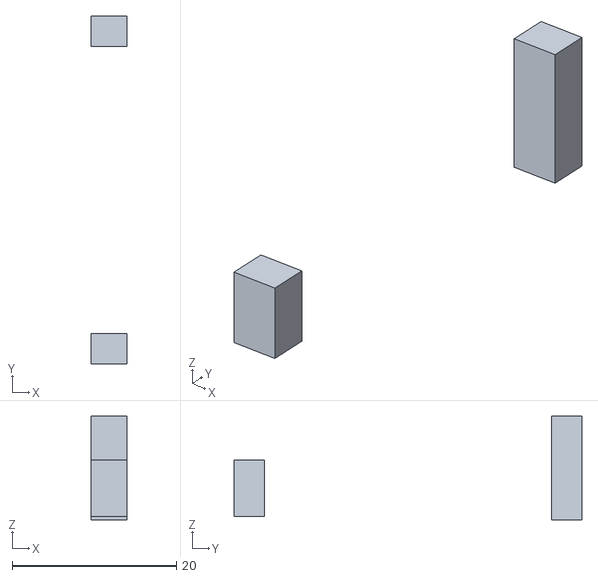
[picture p109: CAD file, 2026-11-03]
bittle_pi_addon/stl/assembly/fdm/amp_ns4168_fbf6ea.stl
4.40 x 42.3 x 12.6
