beetlebugorg/bittlex/bittle_pi_addon/stl/assembly/fdm/wires_speaker_d83a34.stl

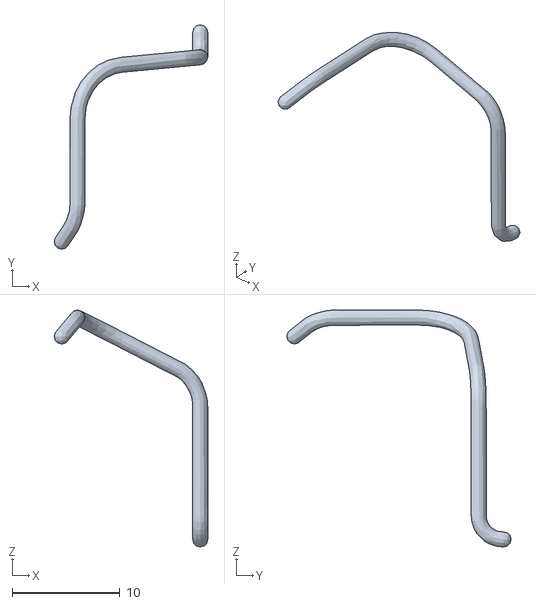
[picture p110: CAD file, 2026-11-03]
bittle_pi_addon/stl/assembly/fdm/wires_speaker_d83a34.stl
14.2 x 20.8 x 22.0
