beetlebugorg/bittlex/bittle_pi_addon/stl/assembly/fdm/pizero_c9ccd1.stl

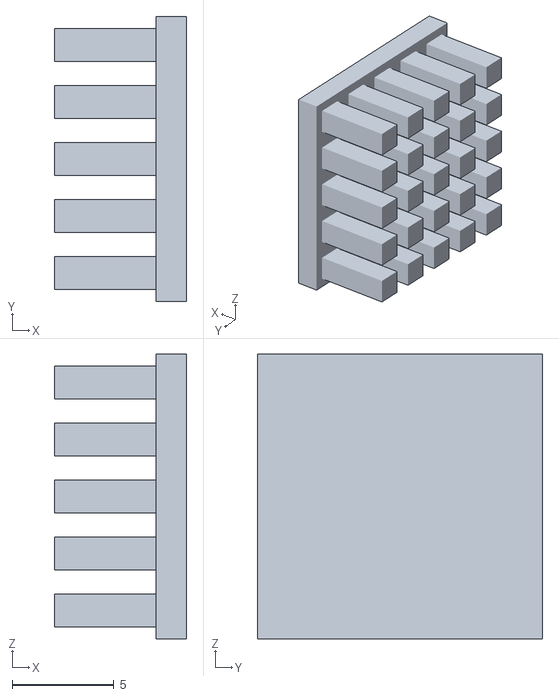
[picture p111: CAD file, 2026-11-03]
bittle_pi_addon/stl/assembly/fdm/pizero_c9ccd1.stl
6.50 x 14.0 x 14.0
