beetlebugorg/bittlex/bittle_pi_addon/stl/assembly/fdm/mic_sph0645_1d1d1f.stl

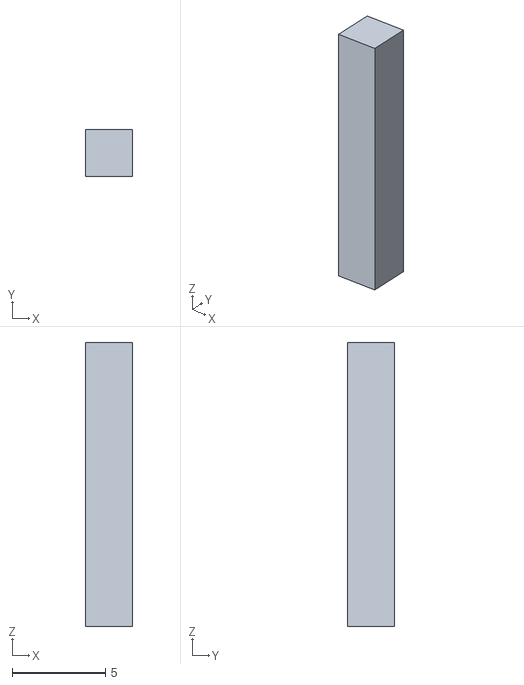
[picture p112: CAD file, 2026-11-03]
bittle_pi_addon/stl/assembly/fdm/mic_sph0645_1d1d1f.stl
2.51 x 2.54 x 15.2
