beetlebugorg/bittlex/bittle_pi_addon/stl/assembly/fdm/wires_amp_1d1d1f.stl

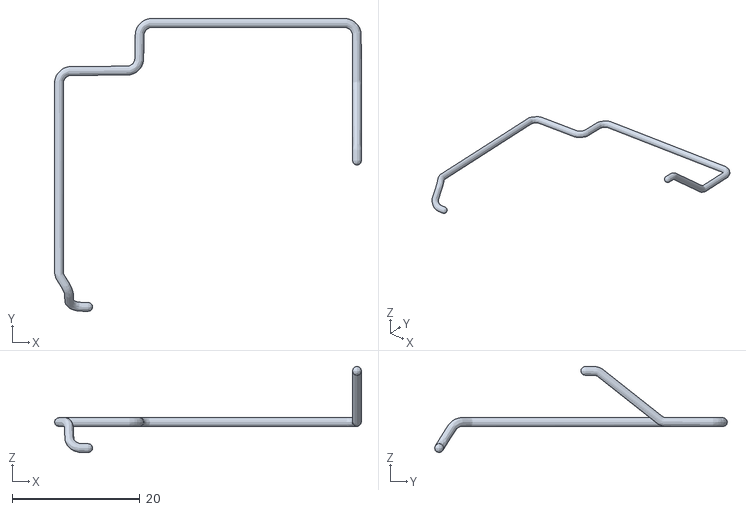
[picture p113: CAD file, 2026-11-03]
bittle_pi_addon/stl/assembly/fdm/wires_amp_1d1d1f.stl
48.0 x 45.7 x 13.5
