beetlebugorg/bittlex/bittle_pi_addon/stl/assembly/fdm/amp_ns4168_2a2a2a.stl

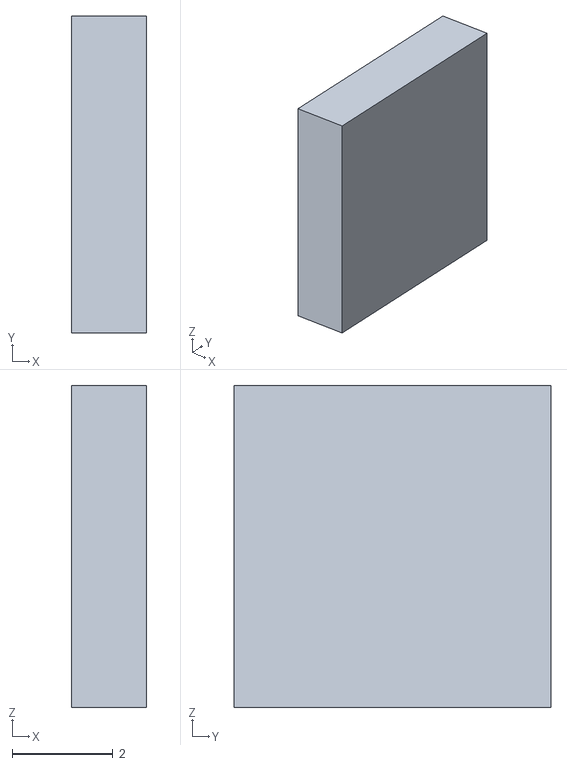
[picture p114: CAD file, 2026-11-03]
bittle_pi_addon/stl/assembly/fdm/amp_ns4168_2a2a2a.stl
1.50 x 6.30 x 6.40
