beetlebugorg/bittlex/bittle_pi_addon/stl/assembly/fdm/wires_mic_e8641b.stl

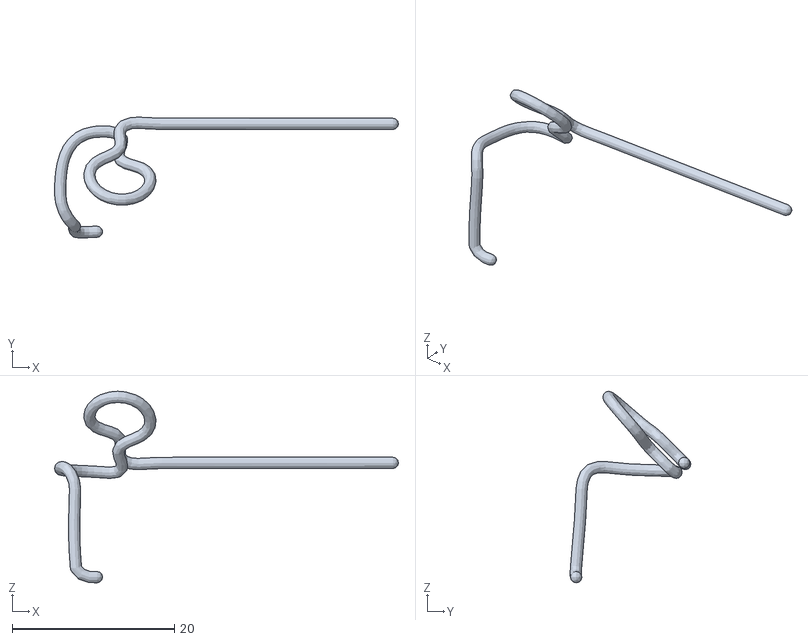
[picture p115: CAD file, 2026-11-03]
bittle_pi_addon/stl/assembly/fdm/wires_mic_e8641b.stl
42.4 x 14.9 x 23.6
