beetlebugorg/bittlex/bittle_pi_addon/stl/assembly/fdm/wires_speaker_1d1d1f.stl

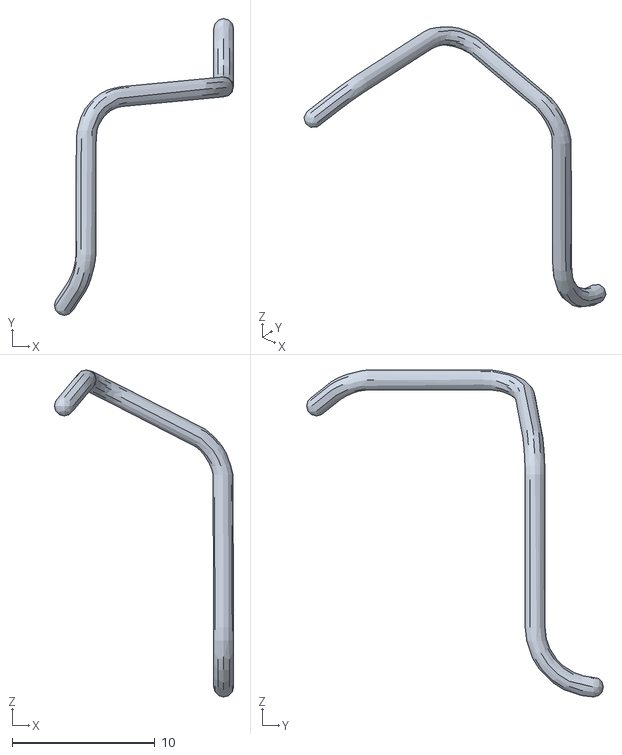
[picture p116: CAD file, 2026-11-03]
bittle_pi_addon/stl/assembly/fdm/wires_speaker_1d1d1f.stl
12.6 x 20.8 x 22.9
