beetlebugorg/bittlex/bittle_pi_addon/stl/assembly/fdm/wires_splice_f2f2ef.stl

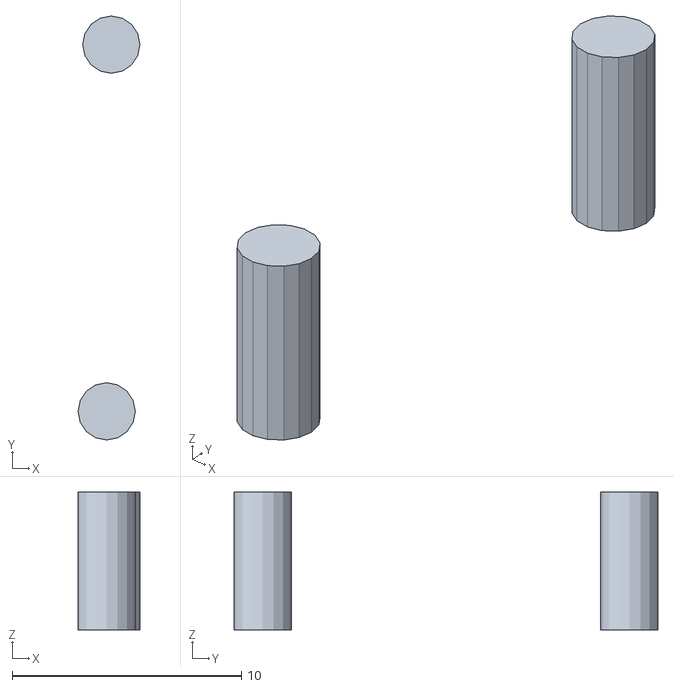
[picture p117: CAD file, 2026-11-03]
bittle_pi_addon/stl/assembly/fdm/wires_splice_f2f2ef.stl
2.70 x 18.5 x 6.00
