beetlebugorg/bittlex/bittle_pi_addon/stl/assembly/fdm/pi_plugs_1d1d1f.stl

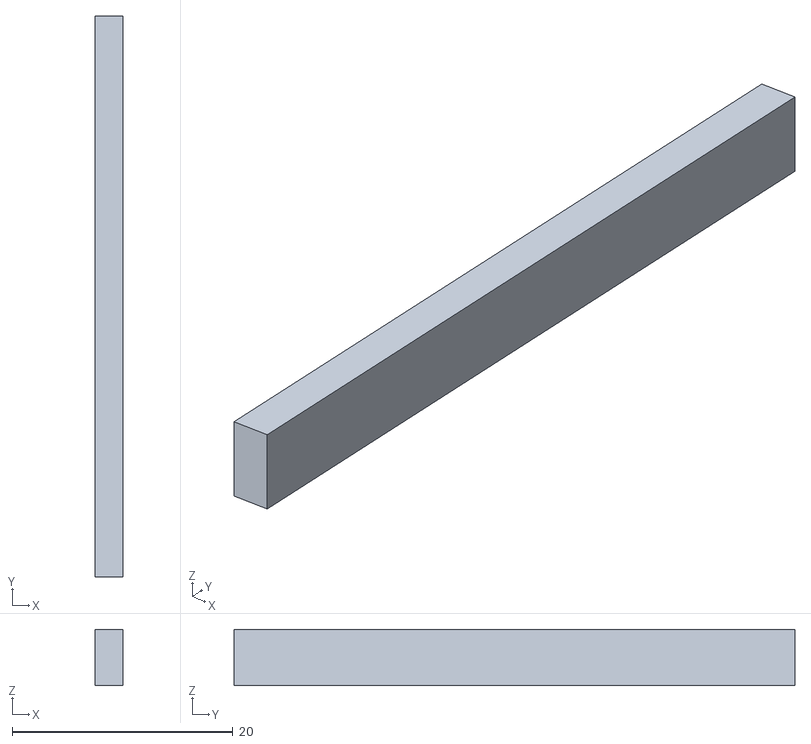
[picture p118: CAD file, 2026-11-03]
bittle_pi_addon/stl/assembly/fdm/pi_plugs_1d1d1f.stl
2.50 x 50.8 x 5.08
