beetlebugorg/bittlex/bittle_pi_addon/stl/assembly/fdm/wires_splice_2e9b4f.stl

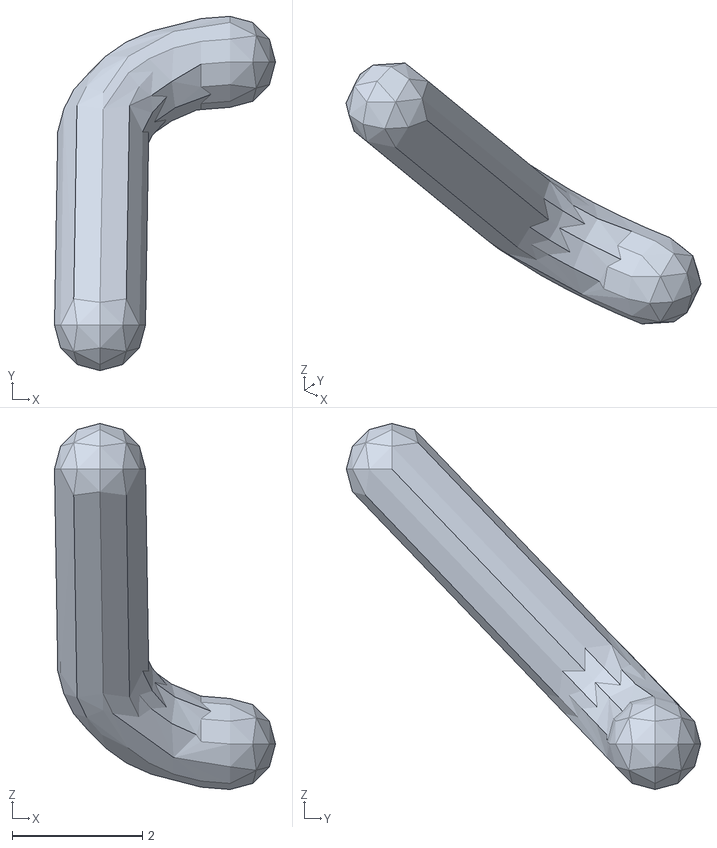
[picture p119: CAD file, 2026-11-03]
bittle_pi_addon/stl/assembly/fdm/wires_splice_2e9b4f.stl
3.40 x 5.45 x 5.63
