beetlebugorg/bittlex/(list of files, cad)

Other CAD files:
bittle_platform/stl/installed/starter_plate.stl
bittle_platform/stl/fit_fine/keyhole_fit_3_gap0.15_click0.35.stl
bittle_platform/stl/installed/cover_pegs.stl
bittle_pi_addon/stl/installed/cover_pegs.stl
bittle_pi_addon/stl/plates/fdm_taz.3mf
bittle_platform/cad/starter_plate.step
bittle_pi_addon/stl/plates/resin_phenom_plate.stl
bittle_platform/stl/fit_fine/keyhole_fit_2_gap0.20_click0.30.stl
bittle_platform/stl/fit_fine/keyhole_fit_14_gap0.10_click0.375_pad0.10x2.stl
bittle_platform/stl/fit_fine/keyhole_fit_plate_fdm.stl
bittle_pi_addon/stl/print/pod_body_fine.3mf
bittle_platform/stl/fit_fine/keyhole_fit_6_gap0.10_click0.40.stl
bittle_platform/stl/fit_fine/keyhole_fit_plate2_fdm.stl
bittle_pi_addon/stl/assembly/fdm/wires_uart_f2f2ef.stl
bittle_platform/stl/fit_fine/keyhole_fit_9_gap0.10_click0.40_pad0.30.stl
bittle_platform/stl/fit_fine/keyhole_fit_4_gap0.12_click0.35.stl
bittle_pi_addon/stl/assembly/fdm/wires_uart_1d1d1f.stl
bittle_platform/stl/fit_fine/keyhole_fit_7_gap0.10_click0.40_pad0.10.stl
bittle_platform/stl/fit_fine/keyhole_fit_10_gap0.10_click0.40_pad0.10x1.stl
bittle_platform/stl/fit_fine/keyhole_fit_13_gap0.10_click0.350_pad0.10x2.stl
bittle_platform/stl/fit_fine/keyhole_fit_8_gap0.10_click0.40_pad0.20.stl
bittle_platform/stl/fit_fine/keyhole_fit_1_gap0.25_click0.25.stl
bittle_platform/stl/fit_fine/keyhole_fit_plate3_fdm.stl
bittle_platform/stl/fit_fine/keyhole_fit_11_gap0.10_click0.35_pad0.10x1.stl
bittle_pi_addon/stl/assembly/fdm/wires_mic_7a4a2a.stl
bittle_platform/stl/fit_fine/keyhole_fit_12_gap0.10_click0.30_pad0.10x2.stl
bittle_pi_addon/stl/assembly/fdm/wires_mic_1d1d1f.stl
bittle_pi_addon/stl/assembly/fdm/wires_uart_9ea0a4.stl
bittle_pi_addon/stl/assembly/fdm/pod_body.stl
bittle_pi_addon/stl/assembly/fdm/pod_door.stl
bittle_pi_addon/stl/assembly/fdm/cover_screw.stl
bittle_pi_addon/stl/assembly/fdm/mount_screws.stl
bittle_pi_addon/stl/assembly/fdm/panel_screws.stl
bittle_pi_addon/stl/assembly/fdm/stack_screws_c8c8c8.stl
bittle_pi_addon/stl/assembly/resin/cover_screw.stl
bittle_pi_addon/stl/assembly/resin/mount_screws.stl
bittle_pi_addon/stl/assembly/resin/panel_screws.stl
bittle_pi_addon/stl/installed/pod_body.stl
bittle_pi_addon/stl/installed/pod_door.stl
bittle_pi_addon/stl/installed/pod_panel.stl
bittle_pi_addon/stl/installed/resin/cover_screw.stl
bittle_pi_addon/stl/installed/resin/pod_body.stl
bittle_pi_addon/stl/installed/resin/pod_door.stl
bittle_pi_addon/stl/installed/resin/pod_panel.stl
bittle_pi_addon/stl/installed/resin/starter_plate_screw.stl
bittle_pi_addon/stl/plates/fdm_taz/cover_screw.stl
bittle_pi_addon/stl/plates/fdm_taz/pod_body.stl
bittle_pi_addon/stl/plates/fdm_taz/pod_door.stl
bittle_pi_addon/stl/plates/fdm_taz/pod_panel.stl
bittle_pi_addon/stl/plates/resin_phenom/cover_screw.stl
bittle_pi_addon/stl/plates/resin_phenom/pod_body.stl
bittle_pi_addon/stl/plates/resin_phenom/pod_door.stl
bittle_pi_addon/stl/plates/resin_phenom/pod_panel.stl
bittle_pi_addon/stl/plates/resin_phenom/starter_plate_screw.stl
bittle_pi_addon/stl/print/cover_screw_fine.stl
bittle_pi_addon/stl/print/pod_body.3mf
bittle_pi_addon/stl/print/pod_body.stl
bittle_pi_addon/stl/print/pod_body_fine.stl
bittle_pi_addon/stl/print/pod_body_screw.3mf
bittle_pi_addon/stl/print/pod_body_screw_fine.3mf
bittle_pi_addon/stl/print/pod_body_screw_fine.stl
bittle_pi_addon/stl/print/pod_panel.stl
bittle_pi_addon/stl/print/pod_panel_screw.stl
bittle_pi_addon/stl/print/pod_panel_screw_fine.stl
bittle_pi_addon/stl/print/resin/cover_screw.stl
bittle_pi_addon/stl/print/resin/pod_body.stl
bittle_pi_addon/stl/print/resin/pod_door.stl
bittle_pi_addon/stl/print/resin/pod_panel.stl
bittle_pi_addon/stl/print/resin/starter_plate_screw.stl
bittle_pi_addon/stl/print/starter_plate_screw_fine.stl
bittle_pi_addon/stl/screw/installed/mount_inserts.stl
bittle_pi_addon/stl/screw/installed/mount_screws.stl
bittle_pi_addon/stl/screw/installed/panel_inserts.stl
bittle_pi_addon/stl/screw/installed/panel_screws.stl
bittle_pi_addon/stl/screw/installed/pod_body.stl
bittle_pi_addon/stl/screw/installed/pod_door.stl
bittle_pi_addon/stl/screw/installed/pod_panel.stl
bittle_platform/stl/print/starter_plate.stl
