beetlebugorg/bittlex/bittle_pi_addon/doc/iso/step01-dark.png

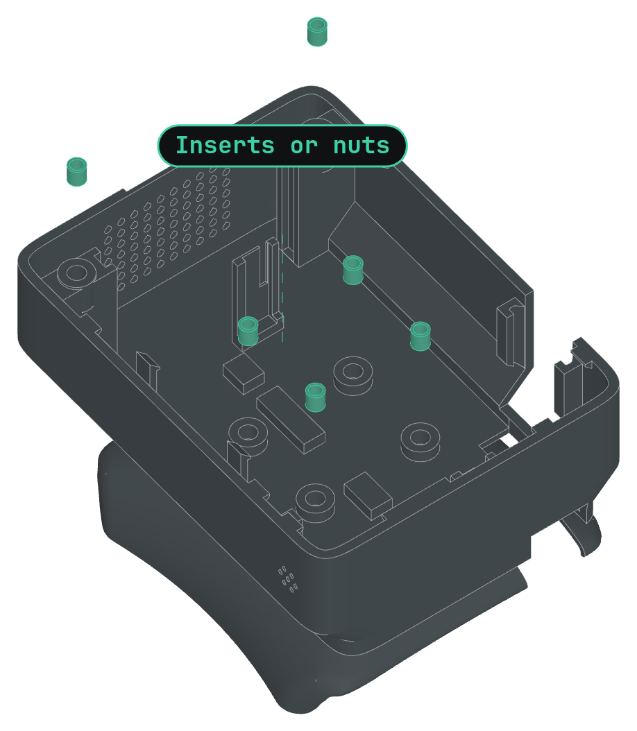
bittle_pi_addon/doc/iso/step01-dark.png
