beetlebugorg/bittlex/bittle_pi_addon/doc/iso/step03-dark.png

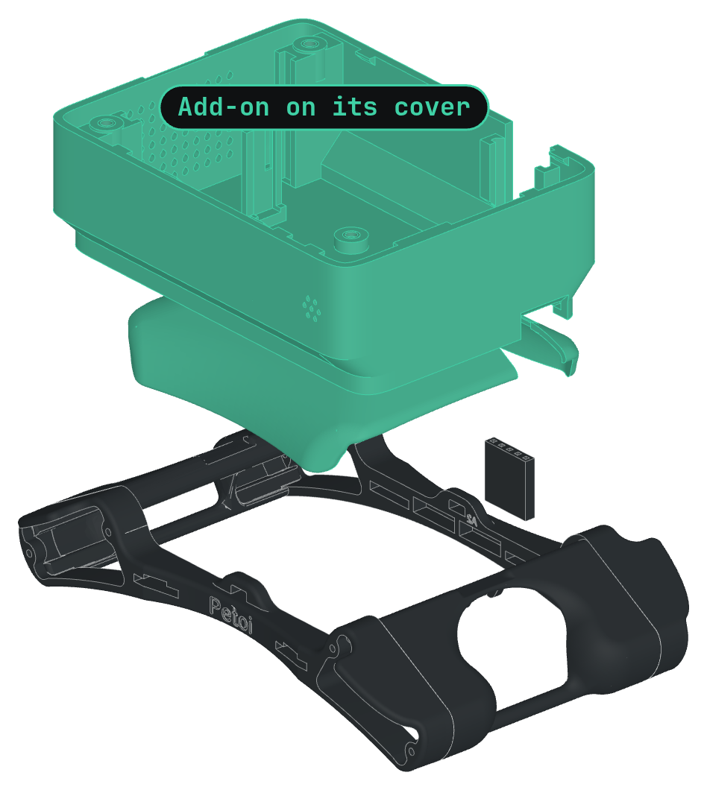
bittle_pi_addon/doc/iso/step03-dark.png
