beetlebugorg/bittlex/bittle_pi_addon/doc/iso/step05-dark.png

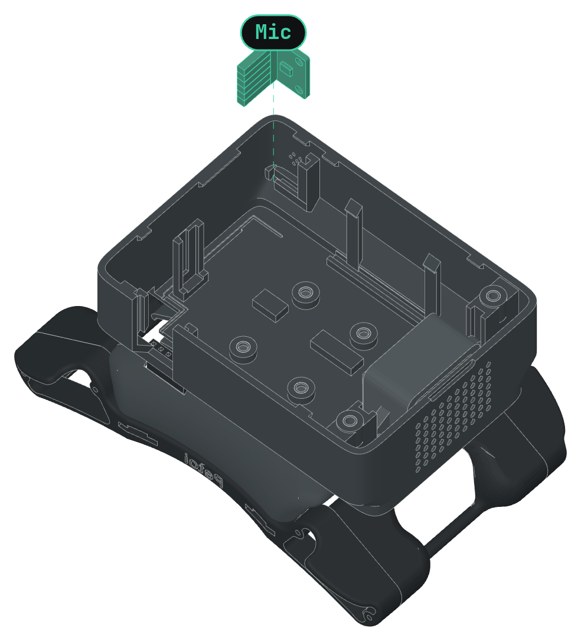
bittle_pi_addon/doc/iso/step05-dark.png
