beetlebugorg/bittlex/bittle_pi_addon/doc/iso/step06-dark.png

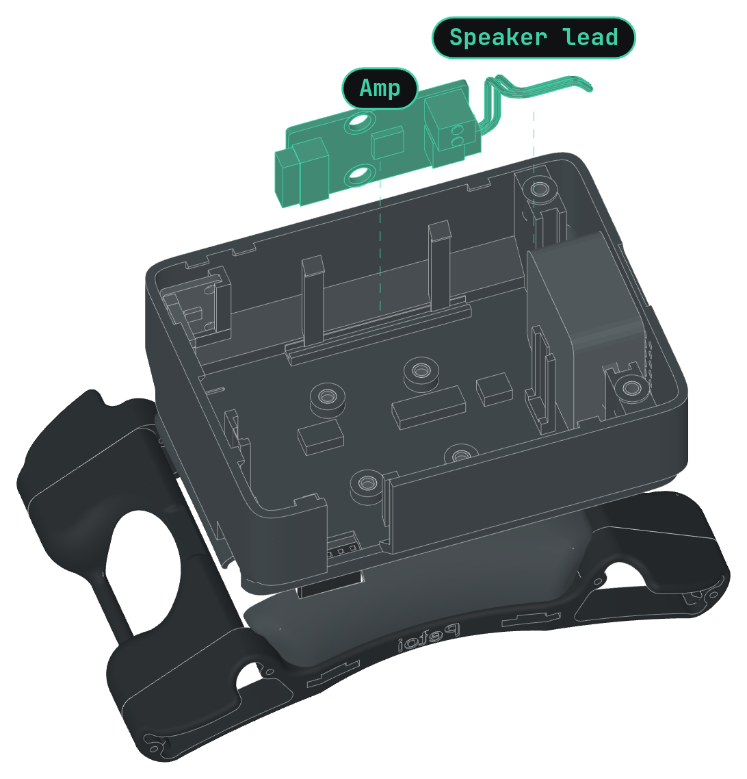
bittle_pi_addon/doc/iso/step06-dark.png
