beetlebugorg/bittlex/bittle_pi_addon/doc/iso/step08-dark.png

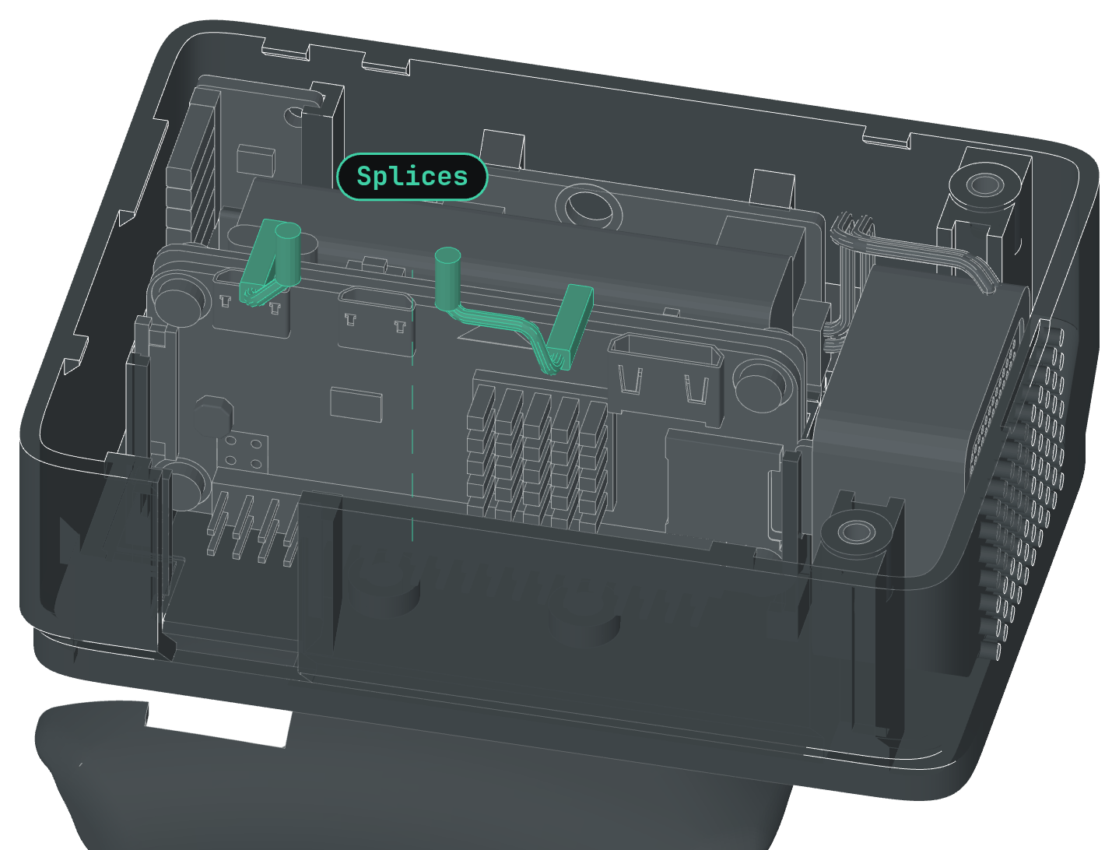
bittle_pi_addon/doc/iso/step08-dark.png
