beetlebugorg/bittlex/bittle_pi_addon/doc/iso/step09-dark.png

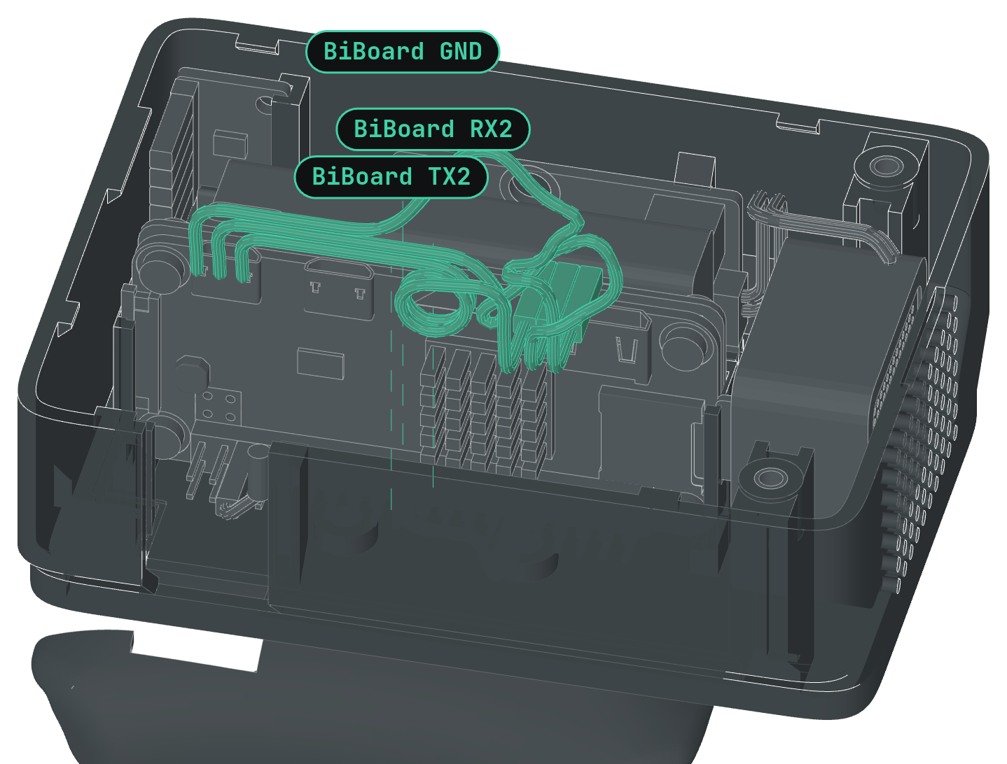
bittle_pi_addon/doc/iso/step09-dark.png
