beetlebugorg/bittlex/bittle_pi_addon/doc/iso/step10-dark.png

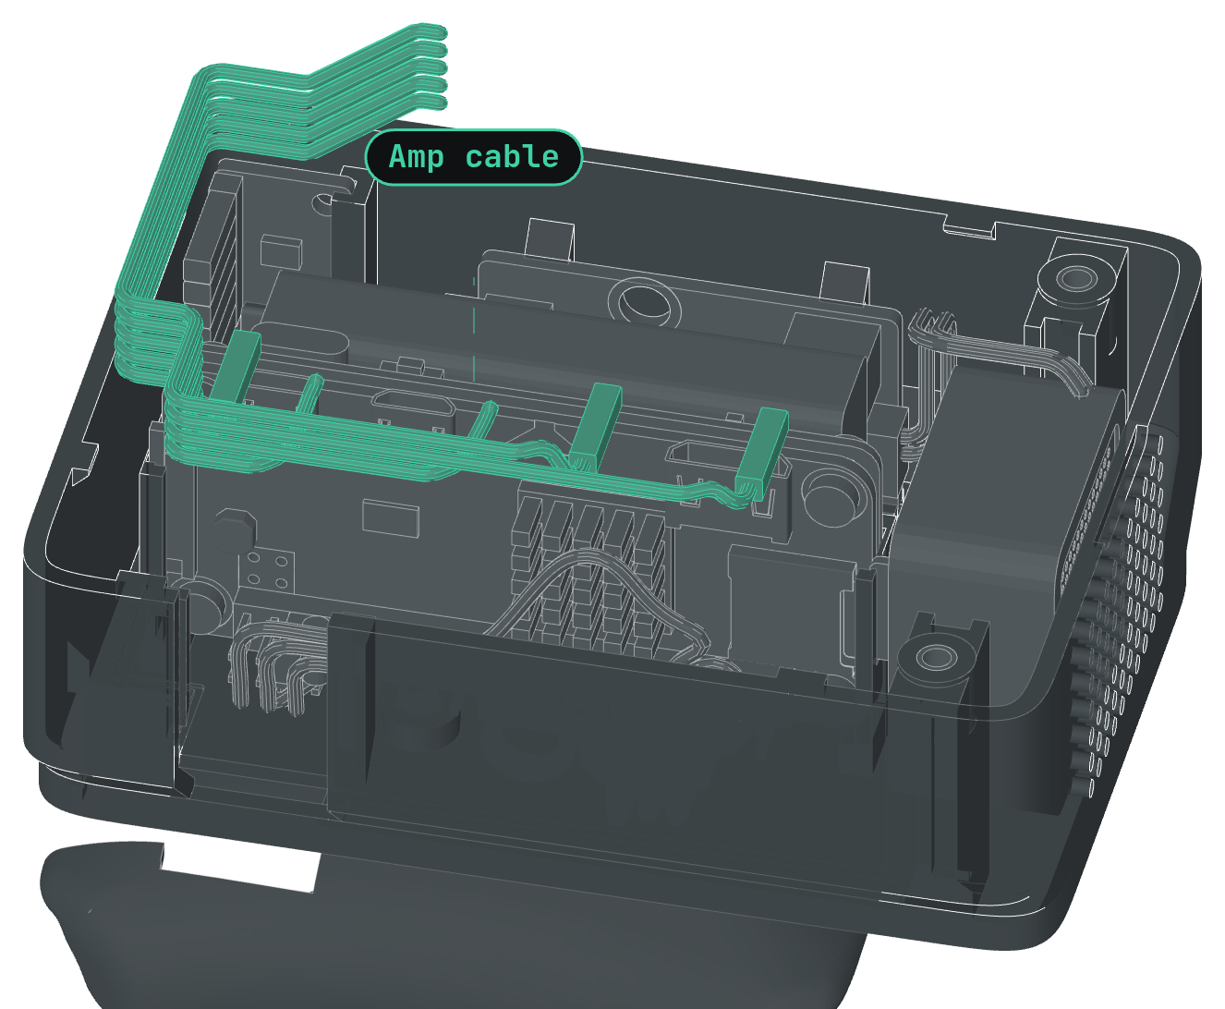
bittle_pi_addon/doc/iso/step10-dark.png
