beetlebugorg/bittlex/(commit log)

2026-10-31 Widen the cover Pi slot and add clamp pads to the clicks (v3.3)
    The Pi slot in the cover is 7.0 mm wide, because the BiBoard Dupont
    plugs did not fit in the old slot. The click travel is 0.20 mm
    (was 0.28), because the add-on was hard to slide on and off.
    DET["pad"] > 0 adds a pad with a ramp on each click beam. The pad
    clamps the peg head and stops lift and tilt. The default is 0.
    stl/fit_fine/ has the keyhole fit test plates 1 to 14.
    [cover_pegs.stl, cover_pegs_foot.stl, detent_bumps.step, keyhole_cutter.step, keyhole_fit_10_gap0.10_click0.40_pad0.10x1.stl, keyhole_fit_11_gap0.10_click0.35_pad0.10x1.stl, keyhole_fit_12_gap0.10_click0.30_pad0.10x2.stl, keyhole_fit_13_gap0.10_click0.350_pad0.10x2.stl]
2026-10-31 Add a screw-mount version of the Pi add-on (rev 0.26)
    Rev 0.25 removes the camera mount, the logo inlays and the button
    cap. A door in the left wall gives access to the BiBoard plugs.
    plates.py makes print plates for the TAZ and the Phenom resin
    printer.
    The keyhole body with test 14 fit is loose on the cover when the pod
    is full. In the screw version, the pod floor has 4 M2.5 heat-set
    inserts, and screws hold it to a cover with no pegs and no logo. Two
    M2.5 x 12 screws go into inserts in the speaker posts and hold the
    panel. The latch is gone, and the lid hook gaps are smaller.
    stl/screw/ is a viewer folder with the screws and the inserts.
    The body has no text labels, because small cut te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
    [camera.stl, camera__case.stl, camera_low.stl, camera_low_pins.stl, coupon_loose.stl, coupon_tight.stl, cover_pegs.stl, cover_screw.stl]
2026-10-31 Remove the wide shoulder ends from the resin plate
    The shoulder ends come from Petoi models and do not go in the
    repository. The resin plate now has the body, the panel, the door, the
    cover and the two fit coupons.
    [coupon_loose.stl, coupon_tight.stl, cover_pegs.stl, pod_body.stl, pod_door.stl, pod_panel.stl, resin_phenom.3mf, resin_phenom_plate.stl]
2026-10-31 Add the Printdeck parts list and the TAZ Workhorse profiles
    printdeck.yml lists the printed parts of the screw version and the
    platform, with the printer, the profile, the material and the Cura
    settings of each. All FDM parts print in black PLA (roll-4).
    profiles/taz-workhorse-se/ is a copy of the profiles in the printdeck
    repository. requirements.txt pins the build packages. The README has
    the build commands.
2026-10-31 Add a starter plate for the screw mount
    starter_plate_screw.stl is the starter plate with an M2.5 insert boss
    at each peg place, in place of the keyholes and the click beams. It
    screws to cover_screw, the same as the pod floor. build.py
    starter_base() is the plate with no mount, and both starter plates use
    it.
    printdeck.yml prints the screw starter plate in place of the keyhole
    plate, and has the resin mix of the Phenom vat.
    [starter_plate_screw.stl]
2026-10-31 Add the Printdeck workflow
    The plan job runs on each push to main, each v* tag and each pull
    request. It runs the generate step of printdeck.yml and sends the plan
    to Printdeck. The slice job runs when Printdeck starts it for an
    approved build. Both jobs use beetlebugorg/printdeck-action@v1.
2026-10-31 Add fine and standard variants of the printed parts
    Each FDM part in printdeck.yml has a fine variant (0.10 mm layers) and
    a standard variant (0.20 mm layers). pod.py writes a *_fine file of
    each screw part for the fine variant.
    pod_panel_screw.stl now has the standard hook gaps, for 0.20 mm
    layers. pod_panel_screw_fine.stl has the 0.05 mm gaps of the old
    file. The other fine files are the same as the standard files.
    [cover_screw_fine.stl, pod_body_screw_fine.3mf, pod_body_screw_fine.stl, pod_door_fine.stl, pod_panel_screw.stl, pod_panel_screw_fine.stl, starter_plate_screw_fine.stl]
2026-10-31 Give the Printdeck runs and jobs clear titles
    The run title has the PR number and title, the branch and commit
    message, or the plates of the build. Printdeck sends the plates in the
    new optional title input of the slice run.
2026-10-31 Use the commit subject as the title of a Printdeck push run
    The run-name is empty on a push, so GitHub uses the first line of the
    commit message. The old title had the full message with its body.
2026-10-31 Plan Printdeck builds on each branch push, also from forks
    The plan job runs on a push of any branch or a v* tag, in place of the
    pull_request trigger. Printdeck links a branch to its open pull
    request. A member's fork runs the plan with its own OIDC token, so
    bittlex runs no code from forks.
    The checkout keeps no token in .git/config. This needs v1 of
    printdeck-action at 246656b or later.
2026-10-31 List the build guide and the platform spec as Printdeck docs
    The plan run uploads each PDF with a picture of its first page. The
    project page shows them in the card Documents.
2026-11-01 Use glued M2.5 nuts in place of inserts for the resin build
    The resin build is the screw version now. A hex pocket at the top of
    each boss holds an M2.5 nut with superglue, in place of a heat-set
    insert. The bosses are 8.0 mm across for resin. The floor nuts are at
    Y 27.0 to 29.0, so the M2.5 x 4 cover screws go fully through them.
    The resin plate has the screw body, panel, door, cover and starter
    plate. The keyhole fit coupons are gone. plates.py writes each resin
    part alone in stl/print/resin/, and printdeck.yml lists each one.
    [coupon_loose.stl, coupon_tight.stl, cover_pegs.stl, cover_screw.stl, pod_body.stl, pod_door.stl, pod_panel.stl, resin_phenom.3mf]
2026-11-01 Document the screw mount in the guide, the spec and the site
    The screw version is the main version now. The guide (v0.26) builds
    it: inserts or nuts, the body screwed to the cover, the unit clipped
    onto the robot, and two panel screws. A new page gives the hardware,
    the tools and the steps for heat-set inserts (FDM) and glued M2.5
    nuts (resin). The figures, the site viewer and the FDM print plate
    use the screw parts.
    The platform spec (v3.4) adds the screw mount for third-party add-ons.
    interface.py has the cover-side numbers, and pod.py reads them.
    build_site.py skips the stl/print/resin folder when it copies files.
    [cover_pegs.stl, cover_screw.stl, fdm_taz.3mf, fdm_taz_plate.stl, pod_body.stl, pod_panel.stl]
2026-11-01 Fit M3 screws through the panel
    The FDM print has M3 heat-set inserts, because the 3.6 mm holes were
    too big for M2.5 inserts. The panel now has a 3.5 mm hole and a
    6.4 x 2.4 mm counterbore for an M3 button or pan head, in an 8.0 mm
    column. The body and the cover do not change.
    The guide, the README and the site list M3 inserts and screws for FDM.
    The resin version keeps the M2.5 nuts and screws.
    [fdm_taz.3mf, fdm_taz_plate.stl, panel_screws.stl, pod_panel.stl, pod_panel_screw.stl, pod_panel_screw_fine.stl, resin_phenom.3mf, resin_phenom_plate.stl]
2026-11-01 Slice the resin parts with the Phenom profile
    Each resin part names peopoly-phenom/abs-like-0.05, copied from
    printdeck/profiles. The slice run of the Action slices a resin plate
    with PrusaSlicer and writes a .cbddlp with the settings of ChiTuBox:
    0.05 mm layers, 12 s, bottom 95 s x 10.
2026-11-01 Print the door on its top edge
    The door printed flat on its outer face, and the 45 deg strip at its
    bottom printed over air on the outside of the robot. On its top edge,
    the outer face prints as a wall with the layers of the body walls, and
    the strip hangs on its hidden inner face. The top ends of the ears
    slope at 45 deg, so they need no support.
    The door fit does not change: pushed 0.3 mm in any direction, it
    touches the body. It is 27 mm tall on a 2 mm edge, so print it with a
    brim.
    [cover_screw.stl, fdm_taz.3mf, fdm_taz_plate.stl, pod_body.stl, pod_door.step, pod_door.stl, pod_door_fine.stl, pod_panel.stl]
2026-11-02 Add the Parts tab fields and assemblies to printdeck.yml
    Each part has a group and a description for the Parts tab of
    Printdeck: what it does, the hardware that goes into it, and how it
    prints. Two assemblies show the FDM version (M3 inserts and screws,
    with the boards as convex hulls) and the resin version (M2.5 nuts and
    screws) in 3D.
    pod.py write_assembly() writes each model in its place with Z up to
    stl/assembly/. The printed parts are simplified to 0.05 mm, so the two
    assemblies are 2.1 MB. The generate step writes them.
    [amp.stl, battery.stl, cover_screw.stl, mic.stl, mount_inserts.stl, mount_screws.stl, panel_inserts.stl, panel_screws.stl]
2026-11-02 Add a cover picture of the add-on for Printdeck
    printdeck.yml names bittle_pi_addon/doc/cover.png as the picture of
    the project on the dashboard. iso_render.py renders the add-on on the
    robot from the side, and make_cover() pads it to 4:3 at 1200 x 900
    with a transparent background.
2026-11-03 Show the real boards and the wires in the Parts tab
    The FDM assembly has the real board and wire models from
    stl/models/parts.json in place of convex hulls. The sub-parts of one
    model with the same color are one item, and the Dupont housings of all
    the wires are one item, so the assembly has 56 items (the limit is
    60). Each board moves out as one in the exploded view.
    The two assemblies are 4.0 MB.
    [amp.stl, amp_ns4168_1d1d1f.stl, amp_ns4168_2a2a2a.stl, amp_ns4168_2f6fd6.stl, amp_ns4168_c8c8c8.stl, amp_ns4168_e8e8e8.stl, amp_ns4168_efe6d2.stl, amp_ns4168_fbf6ea.stl]
2026-11-03 Order the assemblies for the take-apart view
    The Parts tab viewer removes the last item first, along its explode
    direction, when its path is free. The items are now in assembly
    order, and the body is the base. The panel moves to the rear, and the
    viewer lifts it after the 5.5 mm slide. The amp stays in the body,
    because it tilts out from under its nubs.
    The insert models have a 1.3 mm bore, so the 1.25 mm screw models do
    not go inside them.
    [mount_inserts.stl, panel_inserts.stl]
2026-11-03 Add the resin shop links to printdeck.yml
    The resin parts print in a mix of 80% Anycubic grey resin and 20%
    Siraya Tech Tenacious Flex black. The materials section links both,
    so the project page shows them as reorder links.
2026-11-03 Write the Parts tab models in their own pod.py mode
    The generate step of printdeck.yml now checks the assembly files byte
    for byte. pod.py routes the wires with slightly different numbers on
    GitHub, so the wire models of the assembly did not match. python
    pod.py assembly writes the assembly files after pod.py, and the
    generate step does not run it.
2026-11-03 Name the project Bittle X Pod for Pi Zero and the cover the pegged cover
    "Bittle X Platform" sounded like a Petoi product. The repository, the
    site and the guide now name the project Bittle X Pod for Pi Zero, and
    say once that it is an unofficial add-on that Petoi did not make. The
    cover with the four pegs is the pegged cover, and its spec is the peg
    interface spec (bittle_peg_spec.pdf). These names match beetlebug.org.
    In printdeck.yml, the part Platform cover is now Pegged cover, and the
    document Platform spec is now Peg interface spec. The folder
    bittle_platform/, the STL file names and interface.json do not change.
2026-11-03 Add a community project notice and name the project Pod for Bittle X Robot
    The README, ATTRIBUTION.md, the site, the guide, the pod README and the
    peg interface spec say that this is an independent community project.
    It is not affiliated with or endorsed by Petoi, and Bittle and Petoi
    are trademarks of Petoi LLC.
    The project is now Pod for Bittle X Robot. Its tagline lists what the
    pod holds: a Raspberry Pi Zero 2 W, a PiSugar S battery, an amp, a
    speaker and a mic.
2026-11-03 Name the two covers the peg cover and the screw cover
    The cover with the four teardrop pegs is the peg cover, and the cover
    that the pod screws to is the screw cover. In printdeck.yml, Pegged
    cover is now Peg cover, and Cover (screw) and Cover (resin) are now
    Screw cover and Screw cover (resin). The spec is the Peg Cover v3.4
    peg interface spec.
    iso_render.py has a hero-color job: the line-art hero with each part in
    its own color, for beetlebug.org. The figures are rendered again with
    the new names and the current door.
